lemosslucas/CoRA2025/pdfs/Cora2025CodeDocumentation_EN.pdf

# Code Documentation for the Turtle Lines Robot

# CoRA 2025 Competition - UFMG

# Lucas Lemos Ricaldoni

## September

2025

# Contents

1 Introduction | 4
2 Dependencies | 4
3 Main Code Structure: CoRA2025.ino | 4
4 Challenges File: challenges.cpp | 16

1

5 Motor Control File: motors.cpp | 27
6 Constants and Global Variables File: constants.cpp | 28

2

7 Analysis and Visualization Script: plot_log.py | 31
8 Bibliographical References | 35
9 Conclusion | 36

3

# 1 Introduction

### This document presents the documentation for the code developed for the "Turtle Lines" line-following robot, designed for the CoRA 2025 competition at UFMG. The system is based on a microcontroller and uses infrared sensors

for track detection and a gyroscope to assist with navigation.

# 2 Dependencies

### The code was developed in C++ for the Arduino platform. The following libraries are required for the project to compile and run:

- MPU6050.h: (https://github.com/jrowberg/i2cdevlib/tree/master/Arduino/MPU6050) For communication with the MPU6050 gyroscope and accelerometer.
- Wire.h: (https://www.arduino.cc/reference/en/language/functions/communication/wire/) For I2C communication with the MPU6050 sensor.
- SPI.h and SD.h: For communication with the SD card module.

# 3 Main Code Structure: CoRA2025.ino

### The CoRA2025.ino file is the heart of the system, responsible for orchestrating all the robot’s operations, from reading sensors to controlling motors

and executing the competition’s challenge logic.

## 3.1 Function setup()

This function is executed once when the robot is powered on or reset.

### Its main purpose is to initialize all the necessary hardware and software

components for operation.

### - Initializes serial communication and the SD card (if the respective de-

bug modes are active).

4

### - Configures the pins for the line sensors and the LED as inputs and

outputs.

- Initializes I2C communication (Wire) for the gyroscope.

### - Starts and calibrates the gyroscope (MPU6050) to obtain the bias

value.

- Configures the motors for motion control.
- Turns on the front LED to indicate that initialization is complete.
1 | void setup () {
2 | // Initialize serial communication
3 | if ( debugMode ) Serial . begin (9600) ;
4 | if ( debugSD ) setup_sd () ;
5 | // Sensor initialization
6 | pinMode ( sensor_esquerda , INPUT ) ;
7 | pinMode ( sensor_esquerda_central , INPUT ) ;
8 | pinMode ( sensor_central , INPUT ) ;
9 | pinMode ( sensor_direita_central , INPUT ) ;
10 | pinMode ( sensor_direita , INPUT ) ;
11 | pinMode ( sensor_curva_esquerda , INPUT ) ;
12 | pinMode ( sensor_curva_direita , INPUT ) ;
13 | pinMode ( LEDS , OUTPUT ) ;
14 | // Gyroscope initialization
15 | Wire . begin () ;
16 | mpu . begin () ;

17
18 | // turn on motors
19 | setup_motor () ;

20
21 | // Calibrate the gyroscope
22 | gyro_bias_z = calibrate_gyro () ;
23 | // turn on the face LEDs to indicate the robot has started
24 | digitalWrite ( LEDS , HIGH ) ;
25 | tempoLedLigou = millis () ;
26 | ledLigado = true ;
27 | }
Listing 1: Robot initialization function.

## 3.2 Function setup_sd()

### This function initializes the SD card and creates a new log file. To avoid

overwriting data, the function generates a unique file name at each startup,

5

using the value of the Kp constant and a sequential index (e.g., L180_0.TXT,

### L180_1.TXT). If the file is created successfully, a detailed header is written

to facilitate later data analysis.

1 | void setup_sd () {
2 | if (! SD . begin ( chipSelect ) ) {
3 | if ( debugMode ) Serial . println ("SD Card initialization
| failed !") ;
4 | return ;
5 | }

6
7 char newFileName [16];

8
9 | // Search for the first available index
10 | for (int i = 0; i < 100; i ++) {
11 | // Format the file name safely using snprintf
12 | snprintf ( newFileName , sizeof ( newFileName ) , "L%d_%d. TXT ",
| (int ) Kp , i) ;
13 | // Check if the file does NOT exist
14 | if (! SD . exists ( newFileName ) ) {
15 | break ;
16 | // Found an available name
17 | }
18 | }

19
20 | if ( debugMode ) {
21 | Serial . print (" Creating new log file : ") ;
22 | Serial . println ( newFileName ) ;
23 | }

24
25 | // Open the new file for writing
26 | logFile = SD . open ( newFileName , FILE_WRITE ) ;
27 | if ( logFile ) {
28 | logFile . println ("Time ,Error , Challenge , MarcacaoDireita ,
| MarcacaoEsquerda ,T_Dir ,T_Esq , Velocidade Direita , Velocidade
| Esquerda ,sc0 ,s0 ,s1 ,s2 ,s3 ,s4 , sc1 ") ;
29 | logFile . flush () ;
30 | if( debugMode ) Serial . println (" Log file created
| successfully .") ;
31 | } else {
32 | if( debugMode ) Serial . println (" Failed to create the log
| file .") ;
33 | }
34 | }
Listing 2: SD card initialization and log file creation.

6

## 3.3 Function write_sd()

Responsible for writing a line of data to the log file. With each call,

### the function records a complete set of telemetry data, including the time (‘millis()‘), error, a challenge marker, count and time of markings, motor speeds, and the state of all seven sensors. Using ‘logFile.flush()‘ ensures that

the data is written to the card immediately.

1 | void write_sd ( int challenge_marker = 0) {
2 | if ( logFile ) {
3 | logFile . print ( millis () ) ;
4 | logFile . print (",") ;
5 | logFile . print ( erro ) ;
6 | logFile . print (",") ;
7 | logFile . print ( challenge_marker );
8 | logFile . print (",") ;
9 | logFile . print ( marcacoesDireita );
10 | logFile . print (",") ;
11 | logFile . print ( marcacoesEsquerda ) ;
12 | logFile . print (",") ;
13 | logFile . print ( tempoMarcacaoDireita ) ;
14 | logFile . print (",") ;
15 | logFile . print ( tempoMarcacaoEsquerda ) ;
16 | logFile . print (",") ;
17 | logFile . print ( velocidadeDireita ) ;
18 | logFile . print (",") ;
19 | logFile . print ( velocidadeEsquerda ) ;
20 | for (int i = 0; i < 5; i ++) {
21 | logFile . print (",") ;
22 | logFile . print ( SENSOR [ i ]) ;
23 | }
24 | for (int i = 0; i < 2; i ++) {
25 | logFile . print (",") ;
26 | logFile . print ( SENSOR_CURVA [ i ]) ;
27 | }
28 | logFile . println () ;
29 | logFile . flush () ;

30
31 | if ( debugMode ) {
32 | if ( challenge_marker != 0) Serial . println (" Challenge
| event logged to SD.") ;
33 | }
34 | }
35 | }
Listing 3: Writes telemetry data to the SD card.

7

## 3.4 Function ler_sensores()

### Responsible for reading the digital state of the line sensors and the curve

sensors.

### - Updates the global arrays SENSOR and SENSOR_CURVA with the read

values.

- A value of PRETO (1) indicates that the sensor has detected the line, while BRANCO (0) indicates the opposite.
1 | void ler_sensores () {
2 | SENSOR [0] = digitalRead ( sensor_esquerda ) ;
3 | SENSOR [1] = digitalRead ( sensor_esquerda_central ) ;
4 | SENSOR [2] = digitalRead ( sensor_central ) ;
5 | SENSOR [3] = digitalRead ( sensor_direita_central ) ;
6 | SENSOR [4] = digitalRead ( sensor_direita ) ;
7 | SENSOR_CURVA [0] = digitalRead ( sensor_curva_esquerda ) ;
8 | SENSOR_CURVA [1] = digitalRead ( sensor_curva_direita ) ;
9 | }
Listing 4: Reading the line and curve sensors.

## 3.5 Function ajusta_movimento()

Adjusts the motor speeds based on the output value of the PID controller.

### - Calculates the speed for the right and left motors by subtracting and

adding the PID value to the base speed, respectively.

### - Uses the constrain function to ensure that the speed values remain

within the valid range (0 to 255).

- Actuates the motors with the new calculated speeds.
1 | void ajusta_movimento () {
2 | // Change the speed value
3 | velocidadeDireita = constrain ( velocidadeBaseDireita - PID ,
| 0 , 255) ;
4 | velocidadeEsquerda = constrain ( velocidadeBaseEsquerda + PID
| , 0 , 255) ;
5 | // Send the new speed to the run function

8

6 | run ( velocidadeDireita , velocidadeEsquerda ) ;
7 | }
Listing 5: Adjusting the motor speed.

## 3.6 Function calcula_erro()

Calculates the robot’s position error relative to the line.

### - The error is calculated using a weighted average of the readings from

the 5 line sensors.

### - The result indicates the distance and direction of the robot’s deviation

from the center of the line.

### - If all sensors are on the black color, the function considers that the line

has been lost.

- Before the calculation, the function calls verifica_inversao() and, if an inversion is completed, activates the faixa_de_pedestre flag.
1 | void calcula_erro () {
2 | // Update sensor values
3 | ler_sensores () ;
4 | // Check for inversion , signaling a pedestrian crossing
5 | verifica_inversao ( SENSOR , SENSOR_CURVA ) ;

6
7 | if ( inversao_finalizada ) {
8 | faixa_de_pedestre = true ;
9 | }

10
11 | // Initialize variables for error calculation
12 | int pesos [5] = { -2 , -1 , 0, 1 , 2};
13 | int somatorioErro = 0;
14 | int sensoresAtivos = 0;

15
16 | // Perform a summation with the sensor values and weights
17 | for (int i = 0; i < 5; i ++) {
18 | somatorioErro += SENSOR [ i] * pesos [ i ];
19 | sensoresAtivos += SENSOR [i ];
20 | }

21
22 | // Determine the car ’s error
23 | if ( sensoresAtivos == QUANTIDADE_TOTAL_SENSORES ) {

9

24 | erro = LINHA_NAO_DETECTADA ;
25 | } else {
26 | int sensoresInativos = QUANTIDADE_TOTAL_SENSORES -
| sensoresAtivos ;
27 | erro = somatorioErro / sensoresInativos ;
28 | }
29 | }
Listing 6: Calculation of the position error.

## 3.7 Function calcula_PID()

Implements the PID (Proportional-Integral-Derivative) controller.

- Proportional (P): Reacts proportionally to the current error.

### - Integral (I): Accumulates the error over time to correct persistent

deviations.

### - Derivative (D): Responds to the rate of change of the error to dampen

oscillations.

### - The final PID value is the weighted sum of these three components and

is used to adjust the motor speeds.

1 | void calcula_PID () {
2 | // Initialize variables for calculation
3 | PID = 0;
4 | P = erro ;
5 | I = constrain ( I + P , -255 , 255) ;
6 | D = erro - erroAnterior ;
7 | // Calculate PID
8 | PID = ( Kp * P ) + ( Ki * I ) + ( Kd * D ) + OFFSET ;
9 | // Update the previous error value
10 | erroAnterior = erro ;
11 | }
Listing 7: Calculation of the PID control.

## 3.8 Function imprime_serial()

Sends debugging information to the serial monitor.

10

- Prints the state of the curve and line sensors.
- Invokes the error and PID calculation functions and prints their results, as well as the resulting motor speeds.
1 | void imprime_serial () {
2 | // Print sensor values
3 | Serial . print ( SENSOR_CURVA [0]) ;
4 | Serial . print (" | ") ;

5
6 | for (int i = 0; i < 5; i ++) {
7 | Serial . print ( SENSOR [ i ]) ;
8 | Serial . print (" | ") ;
9 | }

10
11 | Serial . print ( SENSOR_CURVA [1]) ;
12 | Serial . print (" | ") ;

13
14 | // Print Error , PID , and speed variables
15 | Serial . print ("\ tErro : ") ;
16 | calcula_erro () ;
17 | Serial . print ( erro ) ;
18 | Serial . print (" PID : ") ;
19 | calcula_PID () ;
20 | Serial . print ( PID ) ;
21 | Serial . print (" Velocidade Direita : ") ;
22 | Serial . print ( velocidadeDireita ) ;
23 | Serial . print (" Velocidade Esquerda : ") ;
24 | Serial . println ( velocidadeEsquerda ) ;
25 | }
Listing 8: Printing debug data.

## 3.9 Main Function loop()

### This is the main loop of the program, executed continuously. The new logic is a more sophisticated state machine to handle the various competition

scenarios.

### 3.9.1 Competition Logic

### - Drag Race Mode: If arrancadaMode is true, the robot performs a

simple line following without the challenge logic.

11

### - Competition Mode:

1. Reading and Detection: In each cycle, the sensors are read, and it is checked if there is a 90-degree curve.

### 2. Pedestrian Crossing: It is detected after a track inversion. The robot waits for a confirmation (counting 3 readings of "all sensors

on black") before executing the stop maneuver.

### 3. Line Following: If no curve is detected and the line is visible, the robot follows the track normally using PID control. Line recovery

attempts are reset after some time if the robot remains stable.
4. Curve/Challenge Detection: If a 90-degree curve is detected, the robot analyzes the side markings to decide the maneuver.

### – Simple Curve: If one or more markings are seen on only one

side, it executes a 90-degree turn to that side.

### – Reverse vs. Intersection: If markings are seen on both sides, the robot measures the time difference between their detection. A significant time difference indicates a reverse maneuver. If the time is very close, it indicates a doubtful

intersection.

### 3.9.2 Exception Handling (Line Loss)

### - Tolerance: If the line is lost, a counter is started. Action is only

taken after a number of cycles (LIMITE_TOLERANCIA_LINHA_PERDIDA) to ignore momentary failures.

### - Recovery: The robot executes the tenta_recuperar_linha() func-

tion. If successful, it increments an attempt counter.

### - Stop Area: If the recovery fails, or if the number of recoveries in

a short period exceeds the limit (LIMITE_TENTATIVAS_RECUPERACAO),

### the robot stops completely in the stop area, considering the course

finished.

### 3.9.3 Debug Mode

### If the debugMode flag is active, the main logic is ignored, and the robot continuously prints sensor data to the serial monitor for calibration and anal-

ysis.

12

56 | void loop () {
57 | // check the state of the led
58 | verifica_estado_led () ;
59 | if (! debugMode ) {
60 | if ( arrancadaMode ) {
61 | ler_sensores () ;
62 | calcula_erro () ;
63 | calcula_PID () ;
64 | ajusta_movimento () ;
65 | if ( debugSD ) write_sd (0) ;
66 | } else {
67 | ler_sensores () ;
68 | int posicao = calcula_posicao ( SENSOR ) ;
69 | if ( posicao != 0) {
70 | ultima_posicao_linha = posicao ;
71 | }
72 | // check if there is a 90 - degree curve
73 | int saidaCurva = verifica_curva_90 ( SENSOR , SENSOR_CURVA
| ) ;
74 | if (! inversaoAtiva ) {
75 | if ( saidaCurva != CURVA_NAO_ENCONTRADA && ( millis () -
| tempoUltimaCurva < DEBOUNCE_TEMPO_CURVA ) ) {
76 | saidaCurva = CURVA_NAO_ENCONTRADA ;
77 | }
78 | }

79
80 | if ( faixa_de_pedestre ) {
81 | // noise filter
82 | if ( calcula_sensores_ativos ( SENSOR ) ==
| QUANTIDADE_TOTAL_SENSORES ) {
83 | qnt_fim_inversao += 1;
84 | }

85
86 | if ( qnt_fim_inversao >= 3) {
87 | if ( debugSD ) write_sd (2) ;
88 | realiza_faixa_de_pedestre () ;
89 | faixa_de_pedestre = false ;
90 | }
91 | }

92
93 | if ( saidaCurva == CURVA_NAO_ENCONTRADA ) {
94 | calcula_erro () ;
95 | if ( erro != LINHA_NAO_DETECTADA ) {
96 | // follow normally
97 | calcula_PID () ;
98 | if (( SENSOR_CURVA [0] == PRETO && SENSOR_CURVA [1] ==
| PRETO ) || inversaoAtiva ) {
99 | ajusta_movimento () ;
100 | }

13

101
102 | if ( millis () - tempoUltimaRecuperacao >
| TEMPO_RESET_TENTATIVAS ) {
103 | tentativasRecuperacao = 0;
104 | }

105
106 | if ( debugSD ) write_sd (0) ;
107 | contadorLinhaPerdida = 0;
108 | } else if ( erro == LINHA_NAO_DETECTADA ) {
109 | // lost the line
110 | if ( contadorLinhaPerdida == 0) {
111 | tempoSemLinha = millis () ;
112 | }
113 | contadorLinhaPerdida ++;
114 | if ( contadorLinhaPerdida >
| LIMITE_TOLERANCIA_LINHA_PERDIDA || millis () -
| tempoSemLinha > 1000) {

115
116 | stop_motors () ;
117 | if ( tenta_recuperar_linha () ) {
118 | contadorLinhaPerdida = 0;
119 | tentativasRecuperacao ++;
120 | tempoUltimaRecuperacao = millis () ;

121
122 | if ( tentativasRecuperacao >=
| LIMITE_TENTATIVAS_RECUPERACAO ) {
123 | erro = erroAnterior ;
124 | if ( debugSD ) write_sd (3) ;
125 | area_de_parada () ;
126 | }
127 | } else {
128 | erro = erroAnterior ;
129 | if ( debugSD ) write_sd (3) ; // Log challenge 3:
| Stop area
130 | area_de_parada () ;
131 | }
132 | }
133 | }
134 | } else if ( saidaCurva != CURVA_NAO_ENCONTRADA ) {
135 | // avoid activating at intersections
136 | if ( calcula_sensores_ativos ( SENSOR ) > 1) {
137 | if (! inversaoAtiva ) {
138 | marcacoesDireita = 0;
139 | marcacoesEsquerda = 0;

140
141 | analisa_marcacoes () ;

142
143 | if ( marcacoesDireita == 1 && marcacoesEsquerda ==
| 1 ) {

14

144 | unsigned long deltaTempo ;
145 | if ( tempoMarcacaoDireita >
| tempoMarcacaoEsquerda ) {
146 | deltaTempo = tempoMarcacaoDireita -
| tempoMarcacaoEsquerda ;
147 | } else {
148 | deltaTempo = tempoMarcacaoEsquerda -
| tempoMarcacaoDireita ;
149 | }

150
151 | if ( deltaTempo >= TOLERANCIA_TEMPO_SIMULTANEO )
| {
152 | saidaCurva = ( tempoMarcacaoDireita <
| tempoMarcacaoEsquerda ) ?
153 | CURVA_DIREITA : CURVA_ESQUERDA ;
154 | realiza_marcha_re ( saidaCurva ) ;
155 | } else {
156 | turn_90 ( CURVA_EM_DUVIDA ) ;
157 | if ( debugSD ) write_sd (6) ;
158 | }
159 | } else if ( marcacoesDireita >= 1 ||
| marcacoesEsquerda >= 1) {
160 | turn_90 ( saidaCurva );
161 | }
162 | }

163
164 | stop_motors () ;
165 | }
166 | }
167 | }
168 | } else {
169 | if ( debugMotor ) {
170 | test_motors () ;
171 | } else {
172 | // Get the output of the car ’s data
173 | ler_sensores () ;
174 | imprime_serial () ;
175 | }
176 | }

177
178 | delay (5) ;
179 | }
Listing 9: Main execution loop of the robot.

15

# 4 Challenges File: challenges.cpp

### This file contains the logic for handling the specific challenges of the competition. It has been restructured to include a more robust state machine

for detecting inversions and more refined logic for each maneuver.

## 4.1 Function verifica_estado_led()

### A simple management function that checks if the LED’s initialization

time (TEMPO_MAX_LED_LIGADO) has passed and, if so, turns off the LED.

1 | void verifica_estado_led () {
2 | if ( ledLigado ) {
3 | if ( millis () - tempoLedLigou >= TEMPO_MAX_LED_LIGADO ) {
4 | digitalWrite ( LEDS , LOW ) ;
5 | ledLigado = false ;
6 | }
7 | }
8 | }
Listing 10: Checks and turns off the status LED after the defined time.

## 4.2 Function calcula_sensores_ativos()

### This helper function counts how many of the five main line sensors are

currently on the black color.

1 | int calcula_sensores_ativos (int SENSOR []) {
2 | int sensoresAtivos = 0;
3 | for(int i = 0; i < 5; i ++) {
4 | sensoresAtivos += SENSOR [ i ];
5 | }
6 | return sensoresAtivos ;
7 | }
Listing 11: Calculates the number of active sensors.

16

## 4.3 Function verifica_curva_90()

### Analyzes the combination of sensor readings to determine if the robot has encountered a 90-degree curve. The logic identifies a curve when at least 2

central sensors are active and one of the side curve sensors is also active.

1 | int verifica_curva_90 ( int SENSOR [] , int SENSOR_CURVA []) {
2 | int sensores_pretos = calcula_sensores_ativos ( SENSOR ) ;

3
4 | if ( SENSOR_CURVA [0] == PRETO && sensores_pretos >= 2 &&
| SENSOR_CURVA [1] == BRANCO ) {
5 | return CURVA_ESQUERDA ;
6 | }
7 | if ( SENSOR_CURVA [0] == BRANCO && sensores_pretos >= 2 &&
| SENSOR_CURVA [1] == PRETO ) {
8 | return CURVA_DIREITA ;
9 | }
10 | if ( SENSOR [1] == PRETO && SENSOR [3] == PRETO &&
| SENSOR_CURVA [0] == BRANCO && SENSOR_CURVA [1] == BRANCO ) {
11 | return CURVA_EM_DUVIDA ;
12 | }

13
14 | return CURVA_NAO_ENCONTRADA ;
15 | }
Listing 12: Checks for the existence of a 90-degree curve.

## 4.4 Function calcula_posicao()

### Calculates a weighted average position of the line based on active sensors, returning a value between -2 and 2. It is used to make small angle

adjustments before a 90-degree turn.

1 | int calcula_posicao ( int SENSOR []) {
2 | int pesos [5] = { -2 , -1 , 0 , 1 , 2};
3 | int somaPesos = 0 , somaAtivos = 0;

4
5 | for (int i = 0; i < 5; i ++) {
6 | if ( SENSOR [ i ] == PRETO ) {
7 | somaPesos += pesos [ i ];
8 | somaAtivos ++;
9 | }
10 | }

11
12 | if ( somaAtivos == 0) return 0;
13 | return somaPesos / somaAtivos ;

17

14 }
Listing 13: Calculates the weighted position of the line.

## 4.5 Function turn_90()

### Executes the 90-degree turn maneuver. The function moves forward until it passes the initial marking, stops, calculates an adjusted turn angle based on the line’s position, and after rotating, moves forward again until it realigns

on the track to avoid duplicate detections.

1 | void turn_90 ( int curvaEncontrada ) {
2 | if (! inversaoAtiva ) {
3 | unsigned long startTime = millis () ;
4 | while ( calcula_sensores_ativos ( SENSOR ) <= 1) {
5 | run ( velocidadeBaseDireita , velocidadeBaseEsquerda ) ;
6 | ler_sensores () ;
7 | }
8 | delay (50) ;

9
10 | stop_motors () ;
11 | delay (100) ;
12 | int posicao = calcula_posicao ( SENSOR ) ;
13 | int ajuste = posicao * 0;
14 | int anguloFinal = 80 + ajuste ;

15
16 | stop_motors () ;
17 | delay (200) ;

18
19 | erro = erroAnterior ;
20 | if ( curvaEncontrada == CURVA_ESQUERDA ) {
21 | turn_right ( velocidadeBaseDireita ,
| velocidadeBaseEsquerda ) ;
22 | turn_until_angle ( anguloFinal ) ;
23 | } else if ( curvaEncontrada == CURVA_DIREITA ) {
24 | turn_right ( velocidadeBaseDireita ,
| velocidadeBaseEsquerda ) ;
25 | turn_until_angle ( anguloFinal ) ;
26 | }

27
28 | stop_motors () ;
29 | delay (100) ;
30 | while ( true ) {
31 | calcula_erro () ;
32 | calcula_PID () ;
33 | ajusta_movimento () ;

18

34 | if ( SENSOR_CURVA [0] == PRETO && SENSOR_CURVA [1] ==
| PRETO && SENSOR [2] == BRANCO ) {
35 | break ;
36 | }
37 | }
38 | tempoUltimaCurva = millis () ;
39 | marcacoesDireita = 0; marcacoesDireita = 0;
40 | }
41 | }
Listing 14: Executes an improved 90-degree turn.

## 4.6 Function calibrate_gyro()

### Calibrates the gyroscope by measuring its drift (bias) while the robot is stationary. The average of multiple readings is calculated and stored to

correct future measurements.

1 | float calibrate_gyro ( int samples = 200) {
2 | if ( debugMode ) Serial . println (" Calibrating gyroscope ...
| Keep the robot stationary .") ;

3
4 | float sum_gz = 0;
5 | for (int i = 0; i < samples ; i ++) {
6 | mpu . update () ;
7 | sum_gz += mpu . getGyroZ () ;
8 | delay (10) ;
9 | }

10
11 | float bias_gz = sum_gz / samples ;

12
13 | if ( debugMode ) {
14 | Serial . print (" Calibration complete . Gyroscope Bias (Gz)
| = ") ;
15 | Serial . println ( bias_gz , 4) ;
16 | }

17
18 | return bias_gz ;
19 | }
Listing 15: Calibrates the gyroscope.

19

## 4.7 Function turn_until_angle()

Performs a precise rotation of the robot until a target angle is reached, using the gyroscope.

1 | void turn_until_angle ( int target_angle = 90) {
2 | unsigned long previous_time = millis () ;
3 | float angle_z = 0;

4
5 | while ( abs ( angle_z ) < target_angle ) {
6 | mpu . update () ;
7 | float angular_velocity_z = mpu . getGyroZ () - gyro_bias_z ;

8
9 | unsigned long current_time = millis () ;
10 | float delta_time = ( current_time - previous_time ) /
| 1000.0;
11 | previous_time = current_time ;

12
13 | angle_z += angular_velocity_z * delta_time ;
14 | delay (10) ;
15 | }
16 | stop_motors () ;
17 | }
Listing 16: Rotates the robot to a specific angle.

## 4.8 Function inverte_sensor()

### Inverts the logic of a sensor (1 becomes 0, 0 becomes 1), allowing the

robot to follow a line of inverted color.

1 | int inverte_sensor ( int sensor ) {
2 | if ( sensor == 1) {
3 | return 0;
4 | }
5 | return 1;
6 | }
Listing 17: Inverts the value of a sensor.

## 4.9 Function verifica_inversao()

### Implements a state machine to detect and manage crossing a section of

the track with inverted colors.

20

### - Entry: Activates the inversion mode (inversaoAtiva) when only 1

line sensor is active.

### - During Inversion: Inverts the reading of all sensors so that the line

follower logic continues to work.

### - Exit: Deactivates the inversion mode when the curve and line sensors indicate the end of the section. Upon exiting, it activates the

inversao_finalizada flag to signal a possible pedestrian crossing.

1 | bool verifica_inversao ( int SENSOR [] , int SENSOR_CURVA []) {
2 | int ativos = calcula_sensores_ativos ( SENSOR ) ;

3
4 | if ( ativos == 1 && ! inversaoAtiva && SENSOR_CURVA [0] ==
| BRANCO && SENSOR_CURVA [1] == BRANCO ) {
5 | inversaoAtiva = true ;
6 | tempoInversaoAtivada = millis () ;
7 | }

8
9 | if ( inversaoAtiva && millis () - tempoInversaoAtivada >
| 1000) {
10 | if ( ativos >= 3 && SENSOR_CURVA [0] == PRETO &&
| SENSOR_CURVA [1] == PRETO ) {
11 | inversaoAtiva = false ;
12 | inversao_finalizada = true ;
13 | return false ;
14 | }
15 | }

16
17 | if ( inversaoAtiva ) {
18 | for (int i = 0; i < 5; i ++) {
19 | SENSOR [ i ] = inverte_sensor ( SENSOR [ i ]) ;
20 | }
21 | return true ;
22 | }
23 | return false ;
24 | }
Listing 18: Checks and handles the track color inversion.

## 4.10 Function realiza_faixa_de_pedestre()

### Executes a robust routine for the pedestrian crossing. The robot stops

for the defined time, reverses slightly to find the line again, realigns on it, and then moves forward at high speed to ensure a complete crossing.

21

1 | void realiza_faixa_de_pedestre () {
2 | stop_motors () ;
3 | delay ( TIMEOUT_FAIXA_PEDESTRE ) ;

4
5 | unsigned long start = millis () ;
6 | while ( erro == LINHA_NAO_DETECTADA || millis () - start <
700) {
7 | ler_sensores () ;
8 | calcula_erro () ;
9 | run_backward (150 , 150) ;
10 | }
11 | stop_motors () ;

12
13 | int pos = calcula_posicao ( SENSOR ) ;
14 | if ( pos < -1) {
15 | run ( - velocidadeBaseDireita , velocidadeBaseEsquerda ) ;
16 | } else if ( pos > 1) {
17 | run ( velocidadeBaseDireita , - velocidadeBaseEsquerda ) ;
18 | }
19 | while ( SENSOR [1] != PRETO && SENSOR [2] != BRANCO && SENSOR
[3] != PRETO ) {
20 | ler_sensores () ;
21 | }
22 | stop_motors () ;
23 | delay (500) ;

24
25 | run (255 , 255) ;
26 | delay ( TIMEOUT_PERIODO_FAIXA ) ;

27
28 // ... ( Crossing finalization logic )

29
30 | inversao_finalizada = false ;
31 | }
Listing 19: Executes the pedestrian crossing challenge with realignment.

## 4.11 Function realiza_marcha_re()

### Executes the reverse gear challenge. The robot stops, moves backward at high speed, stops again, moves forward a little to position itself, and then

performs the 90-degree turn to the determined side.

1 | void realiza_marcha_re ( int lado_da_curva ) {
2 | if ( debugSD ) write_sd (7) ;
3 | stop_motors () ;
4 | delay (1000) ;

22

5
6 | run_backward (255 , 255) ;
7 | delay (1200) ;

8
9 | stop_motors () ;
10 | delay (500) ;

11
12 | run ( velocidadeBaseDireita , velocidadeBaseEsquerda ) ;
13 | delay (200) ;

14
15 turn_90 ( lado_da_curva ) ;

16
17 | stop_motors () ;
18 | delay (500) ;
19 | }
Listing 20: Executes the reverse gear challenge.

## 4.12 Function realiza_rotatoria()

### Controls navigation in the roundabout. After entering, the robot follows the line and uses logic with a flag (aguardando_realinhar) and a detection counter to reliably count the exits, preventing the same exit from being counted multiple times. Upon reaching the desired exit, it executes the

maneuver to leave the roundabout.

1 | void realiza_rotatoria ( int saidaCurva , int saidaDesejada ) {
2 | bool aguardando_realinhar = false ;
3 | static int contador_deteccao_saida = 0;
4 | const int TOLERANCIA_SAIDA = 2;
5 | int saidaAtual = 0;

6
7 | if ( saidaCurva == SAIDA_ESQUERDA ) {
8 | turn_left ( velocidadeBaseDireita , velocidadeBaseEsquerda ) ;
9 | turn_until_angle (90) ;
10 | } else if ( saidaCurva == SAIDA_DIREITA ) {
11 | turn_right ( velocidadeBaseDireita , velocidadeBaseEsquerda )
| ;
12 | turn_until_angle (90) ;
13 | }

14
15 | while ( saidaAtual < saidaDesejada ) {
16 | calcula_erro () ;
17 | ajusta_movimento () ;

18

23

19 | bool saida_detectada = ( SENSOR_CURVA [0] == PRETO &&
| SENSOR_CURVA [1] == BRANCO ) ;
20 | bool robo_realinhado = ( SENSOR_CURVA [0] == PRETO &&
| SENSOR_CURVA [1] == PRETO ) ;

21
22 | if (! aguardando_realinhar ) {
23 | if ( saida_detectada ) {
24 | contador_deteccao_saida ++;
25 | } else {
26 | contador_deteccao_saida = 0;
27 | }
28 | if ( contador_deteccao_saida >= TOLERANCIA_SAIDA ) {
29 | saidaAtual ++;
30 | aguardando_realinhar = true ;
31 | contador_deteccao_saida = 0;
32 | }
33 | } else {
34 | if ( robo_realinhado ) {
35 | aguardando_realinhar = false ;
36 | }
37 | }
38 | }

39
40 | if ( saidaCurva == SAIDA_ESQUERDA ) {
41 | turn_right ( velocidadeBaseDireita ,
| velocidadeBaseEsquerda ) ;
42 | turn_until_angle (90) ;
43 | } else {
44 | turn_left ( velocidadeBaseDireita , velocidadeBaseEsquerda
| ) ;
45 | turn_until_angle (90) ;
46 | }
47 | }
Listing 21: Executes the roundabout challenge with improved exit counting.

## 4.13 Function tenta_recuperar_linha()

### Recovery routine executed when the line is lost. The robot moves backward for a time limit (TIME_WITHOUT_LINE), searching for the line. To con-

firm that the line has been found, it requires 3 consecutive valid readings.

1 | bool tenta_recuperar_linha () {
2 | unsigned long tempoPerdido = millis () ;
3 | int leiturasValidas = 0;

4

24

5 | while ( millis () - tempoPerdido < TIME_WITHOUT_LINE ) {
6 | run_backward ( velocidadeBaseDireita ,
| velocidadeBaseEsquerda ) ;
7 | delay (50) ;
8 | ler_sensores () ;

9
10 | if ( SENSOR [1] == PRETO || SENSOR [2] == PRETO || SENSOR [3]
| == PRETO ) {
11 | leiturasValidas ++;
12 | if ( leiturasValidas >= 3) {
13 | stop_motors () ;
14 | return true ;
15 | }
16 | } else {
17 | leiturasValidas = 0;
18 | }
19 | }
20 | return false ;
21 | }
Listing 22: Attempts to recover the line by moving backward.

## 4.14 Function conta_marcacao()

### Performs the counting of markers (black squares). The logic has been improved to count on the transition to white and require a minimum number of readings (TOLERANCIA_MARCACAO) to avoid noise, ensuring each marker is

counted only once.

1 | int conta_marcacao ( int estadoSensor , int contagemAtual , bool
| & jaContou , int & contadorBranco , unsigned long &
| tempoMarcacao ) {
2 | if ( calcula_sensores_ativos ( SENSOR ) <= 1) return
| contagemAtual ;
3 | if ( marcacoesDireita >= 1 && marcacoesEsquerda >= 1) return
| contagemAtual ;

4
5 | if ( estadoSensor == BRANCO ) {
6 | contadorBranco ++;
7 | if ( contadorBranco >= TOLERANCIA_MARCACAO && ! jaContou ) {
8 | jaContou = true ;
9 | tempoMarcacao = millis () ;
10 | return contagemAtual + 1;
11 | }
12 | } else {
13 | contadorBranco = 0;

25

14 | jaContou = false ;
15 | }
16 | return contagemAtual ;
17 | }
Listing 23: Track marker counting with a noise filter.

## 4.15 Function analisa_marcacoes()

### Orchestrates the detection of challenges. It enters a loop for a defined time (TIMEOUT_MARCACAO) after detecting a curve, calling conta_marcacao

to register the markers on each side and their respective detection times.

1 | void analisa_marcacoes () {
2 | if (! inversaoAtiva ) {
3 | unsigned long tempoUltimaDeteccao = millis () ;
4 | jaContouEsquerda = false ;
5 | jaContouDireita = false ;

6
7 | while (( millis () - tempoUltimaDeteccao < TIMEOUT_MARCACAO )
) {
8 | ler_sensores () ;

9
10 | static int contadorBrancoEsq = 0;
11 | static int contadorBrancoDir = 0;

12
13 | int marcacoesAntesEsq = marcacoesEsquerda ;
14 | int marcacoesAntesDir = marcacoesDireita ;

15
16 | marcacoesEsquerda = conta_marcacao ( SENSOR_CURVA [0] ,
marcacoesEsquerda , jaContouEsquerda , contadorBrancoEsq , tempoMarcacaoEsquerda ) ;
17 | marcacoesDireita | = conta_marcacao ( SENSOR_CURVA [1] ,
marcacoesDireita , jaContouDireita , contadorBrancoDir , tempoMarcacaoDireita ) ;

18
19 | if ( marcacoesEsquerda > marcacoesAntesEsq ||
marcacoesDireita > marcacoesAntesDir ) {
20 | tempoUltimaDeteccao = millis () ;
21 | }

22
23 | if ( marcacoesDireita >= 1 && marcacoesEsquerda >= 1) {
24 | marcacoesDireita = 1;
25 | marcacoesEsquerda = 1;
26 | }
27 | calcula_erro () ;

26

28 | calcula_PID () ;
29 | ajusta_movimento () ;
30 | }
31 | }
32 | }
Listing 24: Analyzes and counts track markers for a set duration.

## 4.16 Function area_de_parada()

### Final function that is called when the robot cannot recover from a line

loss or reaches the attempt limit. It moves forward a little, stops the motors, turns on the LED, and enters an infinite loop, finishing the course.

1 | void area_de_parada () {
2 | run ( velocidadeBaseDireita - 5 , velocidadeBaseEsquerda ) ;
3 | delay (1000) ;
4 | stop_motors () ;
5 | digitalWrite ( LEDS , HIGH ) ;
6 | tempoLedLigou = millis () ;
7 | ledLigado = true ;
8 | if ( debugSD ) write_sd (3) ; // Log challenge 3: Stop area
9 | while ( true ) ;
10 | }
Listing 25: Finishes the course in the stop area.

# 5 Motor Control File: motors.cpp

### This file represents the hardware abstraction layer for controlling the robot’s motors. It is responsible for initializing the microcontroller’s pins and providing a simple interface to perform basic movements like moving

forward, backward, turning, and stopping.

## 5.1 Function setup_motor()

Initializes the motor control pins as outputs.

1 | void setup_motor () {
2 | pinMode ( MOTOR_LEFT_CLKWISE , OUTPUT );

27

3 | pinMode ( MOTOR_LEFT_ANTI , OUTPUT ) ;
4 | pinMode ( MOTOR_RIGHT_CLKWISE , OUTPUT ) ;
5 | pinMode ( MOTOR_RIGHT_ANTI , OUTPUT ) ;
6 | stop_motors () ;
7 | }
Listing 26: Initial configuration of the motor pins.

## 5.2 Function set_state_motor()

### Low-level function that directly applies PWM values (0-255) to the motor

control pins.

1 | void set_state_motor ( int leftCw , int leftCcw , int rightCw ,
| int rightCcw ) {
2 | analogWrite ( MOTOR_LEFT_CLKWISE , leftCw ) ;
3 | analogWrite ( MOTOR_LEFT_ANTI , leftCcw ) ;
4 | analogWrite ( MOTOR_RIGHT_CLKWISE , rightCw ) ;
5 | analogWrite ( MOTOR_RIGHT_ANTI , rightCcw ) ;
6 | }
Listing 27: Sets the state and speed of each motor.

# 6 Constants and Global Variables File: constants.cpp

### This file centralizes all constants and global variables. This approach facilitates parameter adjustment and robot state management without altering

the main logic.

## 6.1 Pins and Hardware

### Defines the physical connections for the sensors, LEDs, and the Chip

Select pin for the SD card.

28

## 6.2 Sensor State Variables

### Arrays that store the readings of the line sensors (SENSOR) and curve

sensors (SENSOR_CURVA).

## 6.3 Speed and Motor Settings

### - velocidadeBase: The default speed, which is higher (255) in drag race

mode and lower (210) in competition mode.

### - OFFSET_MOTORS: An adjustment value to compensate for mechanical

differences between the motors, ensuring straight movement.

- velocidadeDireita, velocidadeEsquerda: Variables that store the speed adjusted by the PID.

## 6.4 PID Control

### - Gains: Kp, Ki, Kd. Notably, in drag race mode (arrancadaMode), the Ki and Kd gains are zeroed, turning the control into a purely Propor-

tional system, which is simpler and more aggressive.

### - Calculation Variables: erro, P, I, D, PID, etc., used for real-time

calculation.

## 6.5 Challenge State Variables

Flags and counters that manage the robot’s state during the competition.

### - inversaoAtiva: Flag that indicates if the robot is on an inverted track

section.

### - inversao_finalizada: Flag activated when exiting an inversion, sig-

naling a possible pedestrian crossing.

- marcacoesDireita, marcacoesEsquerda: Counters for the challenge markers.

29

- tempoMarcacaoDireita, tempoMarcacaoEsquerda: Store the millis() at the moment of a marker’s detection, used to differentiate challenges.

### - ultima_posicao_linha: Stores the last valid position of the line to

aid in recovery.

## 6.6 Debug Control

Boolean flags to activate different test modes.

- debugMode: Activates printing data to the serial monitor.
- debugMotor: Activates a motor test in the loop().
- debugSD: Enables logging to the SD card.

### - arrancadaMode: Activates a simplified performance mode, with higher

speed and only Proportional control.

## 6.7 Tolerance and Time Parameters

Constants that define the robot’s temporal behavior.

- TIMEOUT_FAIXA_PEDESTRE: Stop time at the pedestrian crossing.

### - TIMEOUT_MARCACAO: Duration of the time window to analyze the mark-

ers of a challenge.

### - DEBOUNCE_TEMPO_CURVA: Waiting time to avoid double detection of the

same curve.

### - TOLERANCIA_TEMPO_SIMULTANEO: Time threshold to differentiate a re-

verse gear from an intersection.

- LIMITE_TOLERANCIA_LINHA_PERDIDA: Number of "line lost" cycles before initiating recovery.

30

# 7 Analysis and Visualization Script: plot_log.py

To assist in the PID controller calibration process, a Python script, plot_log.py,

was developed. This tool allows for the analysis of the .TXT log files generated by the robot, visualization of performance in detailed graphs, and most importantly, simulation of the robot’s behavior with different PID constants without the need for a new physical run. The script recalculates the PID

output based on the error history and the new gains provided by the user, also offering automatic suggestions for optimization.

## 7.1 Function calculate_pid_values()

### This is the central function of the simulation. It iterates over each error

record from the log file and recalculates, line by line, what the Proportional,

### Integral, and Derivative terms and the final PID output would have been if the new Kp, Ki, and Kd constants had been used. The logic, including the constraint on the integral term, exactly mirrors the microcontroller’s

behavior.

1 | def calculate_pid_values ( df , Kp , Ki , Kd ) :
2 | pid_values = []
3 | I = 0
4 | erroAnterior = 0
5 | OFFSET = 0

6
7 | for erro in df [’Error ’]:
8 | P = erro
9 | I = I + P
10 | # Constrain the integral term , similar to the Arduino
| code
11 | I = max ( -255 , min (255 , I ) )
12 | D = erro - erroAnterior

13
14 | p_term_val = Kp * P
15 | i_term_val = Ki * I
16 | d_term_val = Kd * D

17
18 | PID = p_term_val + i_term_val + d_term_val + OFFSET
19 | pid_values . append ( PID )

20
21 | erroAnterior = erro

22

31

23 | return pd . DataFrame ({ ’PID ’: pid_values })
Listing 28: Recalculates the PID output with new constants.

## 7.2 Function plot_data()

### This function is responsible for generating the graphical visualization of the data. It creates a window with four superimposed plots:

### - Error vs. Time: Shows the robot’s deviation from the line, including markers for the competition challenges. A smoothed error curve (using

a Savitzky-Golay filter) is overlaid to show the overall trend of the run.

### - Smoothed Error vs. Time: Presents the smoothed error curve for

a clearer view of the trajectory.

### - PID Output vs. Time: Displays the correction value calculated by

the PID.

### - Motor Speeds vs. Time: Shows how the PID output was translated

into the speed of each motor.

1 | def plot_data ( df , Kp , Ki , Kd ) :
2 | fig , ( ax1 , ax2 , ax3 , ax4 ) = plt . subplots (4 , 1 , figsize
| =(14 , 12) , sharex = True )
3 | fig . suptitle ( f" Analysis of PID Control with Kp ={ Kp} , Ki ={
| Ki} , Kd ={ Kd}", fontsize =16)

4
5 | try :
6 | window_length = min (51 , len ( df [’Error ’]) )
7 | if window_length % 2 == 0:
8 | window_length -= 1

9
10 | if window_length > 3:
11 | df [’ Smoothed_Error ’] = savgol_filter ( df [’Error ’
| ] , window_length , 3)
12 | else :
13 | df [’ Smoothed_Error ’] = df [’Error ’]
14 | except Exception :
15 | df [’ Smoothed_Error ’] = df [’Error ’]

16
17 | ax1 . plot ( df [’Time ’] , df [’Error ’] , | marker =’o’, label =’
Error ( Actual Path )’, color =’blue ’, alpha =0.4)

32

18 | ax1 . plot ( df [’Time ’] , df [’ Smoothed_Error ’] , label =’
| Smoothed Trend ’, color =’green ’, linewidth =2.5)
19 | ax1 . axhline (0 , color =’k’, linestyle =’--’, linewidth =1 ,
| label =’Ideal Path ( Error =0) ’)

20
21 | if ’Challenge ’ in df . columns and not df [ df [’Challenge ’]
| != 0]. empty :
22 | challenges = df [ df [’Challenge ’] != 0]
23 | plotted_labels = set ()

24
25 | for _ , row in challenges . iterrows () :
26 | challenge_code = int ( row [’Challenge ’])
27 | if challenge_code in challenge_map :
28 | props = challenge_map [ challenge_code ]
29 | label = props [’label ’]

30
31 | current_label = label if label not in
| plotted_labels else ""

32
33 | ax1 . scatter ( row [’Time ’] , row [’Error ’] ,
34 | label = current_label ,
35 | color = props [’color ’] ,
36 | marker = props [’marker ’] ,
37 | s = props [’size ’] ,
38 | zorder =5)
39 | plotted_labels . add ( label )

40
41 | ax1 . set_title (’Error vs Time ’)
42 | ax1 . legend ( loc =’center left ’, bbox_to_anchor =(1 , 0.5) )

43
44 | ax2 . plot ( df [’Time ’] , df [’ Smoothed_Error ’] , label =’
| Smoothed_Error ’, color =’green ’, linewidth =2.5)
45 | ax2 . set_title (’ Smoothed_Error vs Time ’)

46
47 | ax3 . plot ( df [’Time ’] , df [’PID ’] , label =’Total PID Output ’,
| color =’red ’)
48 | ax3 . set_title (’PID Output vs Time ’)

49
50 | ax4 . plot ( df [’Time ’] , df [’ Velocidade Direita ’] , label =’
| Velocidade Direita ’, color =’purple ’)
51 | ax4 . plot ( df [’Time ’] , df [’ Velocidade Esquerda ’] , label =’
| Velocidade Esquerda ’, color =’orange ’)
52 | ax4 . set_title (’Motor Speeds vs. Time ’)

53
54 | plt . tight_layout ( rect =[0 , 0.03 , 0.85 , 0.95])
55 | plt . show ()
Listing 29: Generates the performance analysis graphs.

33

## 7.3 Function analyze_performance_and_suggest_pid()

After visualizing the graphs, this function performs a quantitative analysis of the robot’s performance. It calculates metrics such as mean absolute error (MAE), maximum error (overshoot), and the number of oscillations (using peak detection). Based on these metrics, it prints a diagnosis of the robot’s behavior in the terminal and suggests clear actions for adjusting the PID

gains, automating the calibration process.

1 | def analyze_performance_and_suggest_pid ( df , Kp , Ki , Kd ) :
2 | print ("\n- - - Performance Analysis & Adjustment
Suggestions ---")

3
4 | error = df [’Error ’]. to_numpy ()
5 | mae = np . mean ( np .abs ( error ) )
6 | max_abs_error = np . max ( np . abs ( error ) )

7
8 | peaks , _ = find_peaks ( error , prominence =0.5)
9 | troughs , _ = find_peaks (- error , prominence =0.5)
10 | num_oscillations = len ( peaks ) + len ( troughs )

11
12 | print ( f" Mean Absolute Error ( MAE ): { mae :.4 f}")
13 | print ( f" Maximum Absolute Error ( Overshoot / Undershoot ): {
max_abs_error :.4 f}")
14 | print ( f" Detected { num_oscillations } significant
oscillations .")

15
16 | print ("\ nSuggestions :")
17 | suggestion_made = False

18
19 | if num_oscillations > 8:
20 | print ("- Behavior Detected : The robot oscillates too
much ... ")
21 | print ( f" | - Recommended Action : Decrease the value of
Kp ( current : {Kp }).")
22 | suggestion_made = True

23
24 | # ... ( logic for other suggestions ) ...

25
26 | if not suggestion_made :
27 | print ("- Performance seems reasonable .")
Listing 30: Analyzes metrics and suggests adjustments for the PID.

34

## 7.4 Example of Graphical Output

### Figure 1 illustrates the analysis window generated by the plot_log.py script. It is possible to observe the error behavior (top graph), the PID controller output (middle graph), and the resulting motor speeds (bottom graph). The colored markers on the first graph indicate the exact moments

when competition events occurred, such as the detection of an ‘invertedline‘(bluesquare), the‘P edestrianCrossing‘maneuver(orangesquare), andthe‘StopArea‘(orangedot).

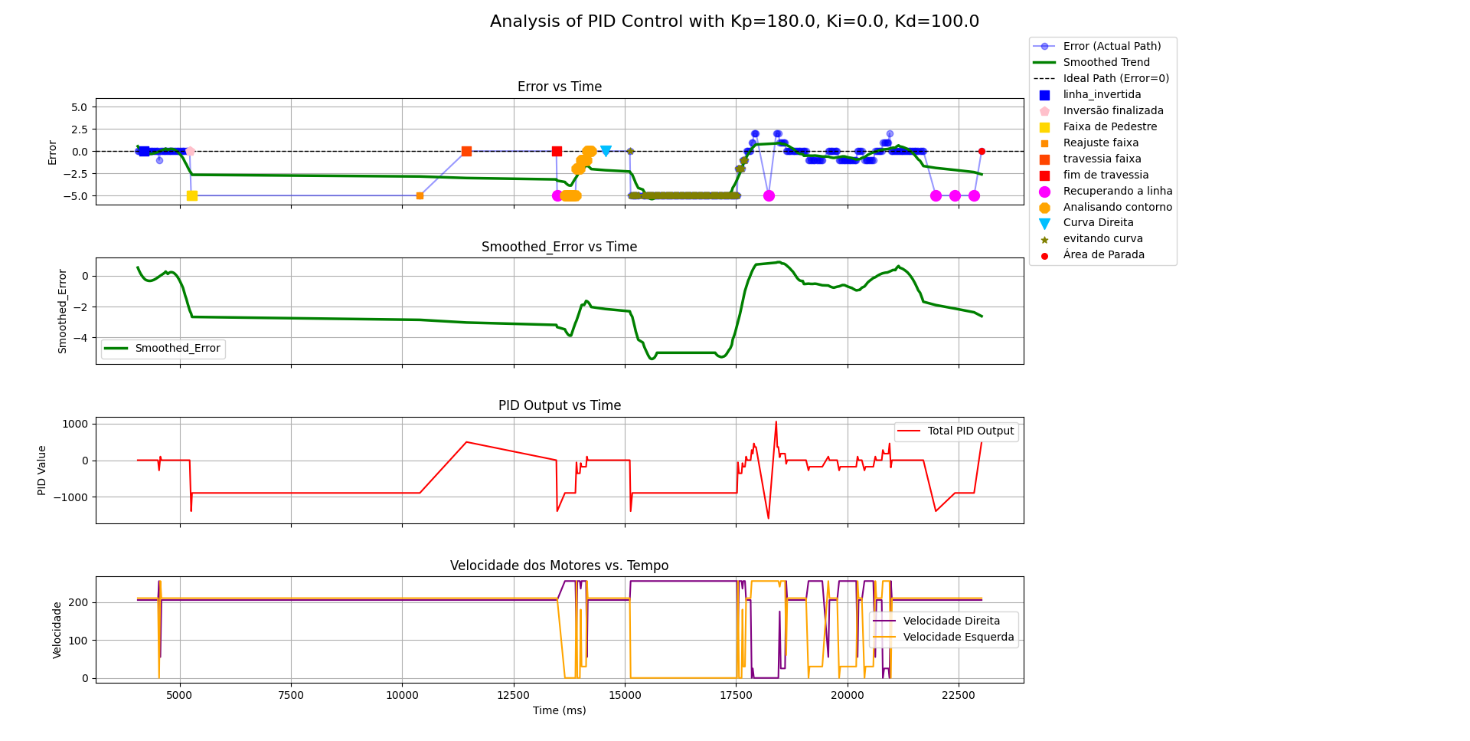
[picture p4: figure]

### Figure 1: Example of the analysis window generated by the plot_log.py

script.

# 8 Bibliographical References

## 8.1 PID Control

PID (Proportional Integral Derivative) Control is used for process control. Its objective is, through mathematical equations involving integrals and derivatives, to minimize the system’s error. The proportional control adjusts the control variable proportionally to the error. The integral control adjusts the control variable based on the time the error occurs. The derivative

control adjusts the control variable based on the rate of change of the error.

35

### PID control equation:

### P ID(t) = Kpe(t) + Ki

Z t

0

### e(τ ) dτ + Kd

d
dte(t) | (1)

### In this equation, we have the following parameters:

- Kp: proportional gain;
- Ki

: integral gain;

- Kd: derivative gain;

### - e: instantaneous error (difference between the desired value and the

measured value);

- τ : integration variable;
- t: current time.

### Below is a table explaining how to adjust the PID parameters according

to the error the robot exhibits.

Robot Behavior | Parameter to Ad-just | Recommended Action
Oscillates a lot around the line (zig-zag) | Proportional (Kp) | Decrease the value of Kp. A very high Kp causes exaggerated reactions.
Corrects slowly and cannot follow the line well | Proportional (Kp) | Increase the value of Kp. A very low Kp generates weak corrections.
A small error persists for a long time | Integral (Ki) | Increase Ki to correct slowly accumu-lating errors.
Starts oscillating after following well for a while | Integral (Ki) | Decrease Ki. A high Ki can accumulate too much error and cause instability.
Very abrupt reaction to rapid changes in the line | Derivative (Kd) | Increase Kd to smooth the response. It helps to "brake" sudden changes.
Slow response to rapid changes | Derivative (Kd) | Decrease Kd if the robot takes too long to react to curves or deviations.

### Table 1: Adjusting PID parameters based on the robot’s behavior

# 9 Conclusion

This document presents the structure and functionalities of the code,

### facilitating the understanding of the system and promoting its democratization. It provides freedom and autonomy for conducting tests and using the

36

### code in different contexts, allowing for greater flexibility in the development

and improvement of the project.

37
