lemosslucas/CoRA2025/pdfs/DocumentaçãoCodigoCoRA2025_PT.pdf

# Documentação do Código do Robô Tartaruga Linhas

# Competição CoRA 2025 - UFMG

# Lucas Lemos Ricaldoni

## Setembro

2025

# Sumário

1 Introdução | 4
2 Dependências | 4
3 Estrutura do Código Principal: CoRA2025.ino | 4
4 Arquivo de Desafios: challenges.cpp | 16

1

5 Arquivo de Controle dos Motores: motors.cpp | 28
6 Arquivo de Constantes e Variáveis Globais: constants.cpp | 29

2

7 Script de Análise e Visualização: plot_log.py | 31
8 Referências Bibliográficas | 36
9 Conclusão | 37

3

# 1 Introdução

### Este documento apresenta a documentação do código desenvolvido para o robô seguidor de linha "Tartaruga Linhas", projetado para a competição CoRA 2025 da UFMG. O sistema é baseado em um microcontrolador e utiliza sensores infravermelhos para a detecção da pista e um giroscópio para auxiliar

na navegação.

# 2 Dependências

### O código foi desenvolvido em C++ para a plataforma Arduino. As seguintes bibliotecas são necessárias para a compilação e funcionamento do projeto:

- MPU6050.h: (https://github.com/jrowberg/i2cdevlib/tree/master/Arduino/MPU6050) Para comunicação com o giroscópio e acelerômetro MPU6050.
- Wire.h: (https://www.arduino.cc/reference/en/language/functions/communication/wire/) Para comunicação I2C com o sensor MPU6050.
- SPI.h e SD.h: Para comunicação com o módulo de cartão SD.

# 3 Estrutura do Código Principal: CoRA2025.ino

### O arquivo CoRA2025.ino é o coração do sistema, responsável por orquestrar todas as operações do robô, desde a leitura dos sensores até o controle

dos motores e a execução das lógicas de desafios da competição.

## 3.1 Função setup()

### Esta função é executada uma única vez quando o robô é ligado ou resetado. Sua principal finalidade é inicializar todos os componentes de hardware

e software necessários para o funcionamento.

### - Inicializa a comunicação serial e com o cartão SD (se os respectivos

modos de depuração estiverem ativos).

4

### - Configura os pinos dos sensores de linha e do LED como entradas e

saídas.

- Inicializa a comunicação I2C (Wire) para o giroscópio.
- Inicia e calibra o giroscópio (MPU6050) para obter o valor de bias.
- Configura os motores para o controle de movimento.
- Acende o LED frontal para indicar que a inicialização foi concluída.
1 | void setup () {
2 | // Initialize serial communication
3 | if ( debugMode ) Serial . begin (9600) ;
4 | if ( debugSD ) setup_sd () ;
5 | // Sensor initialization
6 | pinMode ( sensor_esquerda , INPUT ) ;
7 | pinMode ( sensor_esquerda_central , INPUT ) ;
8 | pinMode ( sensor_central , INPUT ) ;
9 | pinMode ( sensor_direita_central , INPUT ) ;
10 | pinMode ( sensor_direita , INPUT ) ;
11 | pinMode ( sensor_curva_esquerda , INPUT ) ;
12 | pinMode ( sensor_curva_direita , INPUT ) ;
13 | pinMode ( LEDS , OUTPUT ) ;
14 | // Gyroscope initialization
15 | Wire . begin () ;
16 | mpu . begin () ;

17
18 | // liga os motores
19 | setup_motor () ;

20
21 | // Calibrate the gyroscope
22 | gyro_bias_z = calibrate_gyro () ;
23 | // liga os leds da cara para indicar que o robo iniciou
24 | digitalWrite ( LEDS , HIGH ) ;
25 | tempoLedLigou = millis () ;
26 | ledLigado = true ;
27 | }
Listing 1: Função de inicialização do robô.

## 3.2 Função setup_sd()

### Esta função inicializa o cartão SD e cria um novo arquivo de log. Para evitar a sobrescrita de dados, a função gera um nome de arquivo único a

5

### cada inicialização, usando o valor da constante Kp e um índice sequencial (ex: L180_0.TXT, L180_1.TXT). Se o arquivo for criado com sucesso, um

cabeçalho detalhado é escrito para facilitar a análise posterior dos dados.

1 | void setup_sd () {
2 | if (! SD . begin ( chipSelect ) ) {
3 | if ( debugMode ) Serial . println ("SD Card initialization
| failed !") ;
4 | return ;
5 | }

6
7 char newFileName [16];

8
9 | // Procura o primeiro indice disponivel
10 | for ( int i = 0; i < 100; i ++) {
11 | // Formata o nome do arquivo de forma segura usando
| snprintf
12 | snprintf ( newFileName , sizeof ( newFileName ) , "L%d_%d. TXT ",
| (int ) Kp , i) ;
13 | // Verifica se o arquivo Nao existe
14 | if (! SD . exists ( newFileName ) ) {
15 | break ;
16 | // Encontrou um nome disponivel
17 | }
18 | }

19
20 | if ( debugMode ) {
21 | Serial . print (" Creating new log file : ") ;
22 | Serial . println ( newFileName ) ;
23 | }

24
25 | // Abre o novo arquivo para escrita
26 | logFile = SD . open ( newFileName , FILE_WRITE );
27 | if ( logFile ) {
28 | logFile . println ("Time ,Error , Challenge , MarcacaoDireita ,
| MarcacaoEsquerda ,T_Dir ,T_Esq , Velocidade Direita , Velocidade
| Esquerda ,sc0 ,s0 ,s1 ,s2 ,s3 ,s4 , sc1 ") ;
29 | logFile . flush () ;
30 | if( debugMode ) Serial . println (" Log file created
| successfully .") ;
31 | } else {
32 | if( debugMode ) Serial . println (" Failed to create the log
| file .") ;
33 | }
34 | }
Listing 2: Inicialização do cartão SD e criação do arquivo de log.

6

## 3.3 Função write_sd()

### Responsável por escrever uma linha de dados no arquivo de log. A cada

chamada, a função registra um conjunto completo de dados de telemetria,

### incluindo o tempo (‘millis()‘), o erro, um marcador de desafio, contagem e tempo das marcações, velocidades dos motores e o estado de todos os sete sensores. O uso de ‘logFile.flush()‘ garante que os dados sejam gravados

imediatamente no cartão.

1 | void write_sd ( int challenge_marker = 0) {
2 | if ( logFile ) {
3 | logFile . print ( millis () ) ;
4 | logFile . print (",") ;
5 | logFile . print ( erro ) ;
6 | logFile . print (",") ;
7 | logFile . print ( challenge_marker ) ;
8 | logFile . print (",") ;
9 | logFile . print ( marcacoesDireita ) ;
10 | logFile . print (",") ;
11 | logFile . print ( marcacoesEsquerda ) ;
12 | logFile . print (",") ;
13 | logFile . print ( tempoMarcacaoDireita ) ;
14 | logFile . print (",") ;
15 | logFile . print ( tempoMarcacaoEsquerda ) ;
16 | logFile . print (",") ;
17 | logFile . print ( velocidadeDireita ) ;
18 | logFile . print (",") ;
19 | logFile . print ( velocidadeEsquerda ) ;
20 | for ( int i = 0; i < 5; i ++) {
21 | logFile . print (",") ;
22 | logFile . print ( SENSOR [ i ]) ;
23 | }
24 | for ( int i = 0; i < 2; i ++) {
25 | logFile . print (",") ;
26 | logFile . print ( SENSOR_CURVA [ i ]) ;
27 | }
28 | logFile . println () ;
29 | logFile . flush () ;

30
31 | if ( debugMode ) {
32 | if ( challenge_marker != 0) Serial . println (" Challenge
| event logged to SD.") ;
33 | }
34 | }
35 | }
Listing 3: Escreve dados de telemetria no cartão SD.

7

## 3.4 Função ler_sensores()

### Responsável por ler o estado digital dos sensores de linha e dos sensores

de curva.

- Atualiza os arrays globais SENSOR e SENSOR_CURVA com os valores lidos.

### - Um valor PRETO (1) indica que o sensor detectou a linha, enquanto

BRANCO (0) indica o contrário.

1 | void ler_sensores () {
2 | SENSOR [0] = digitalRead ( sensor_esquerda );
3 | SENSOR [1] = digitalRead ( sensor_esquerda_central ) ;
4 | SENSOR [2] = digitalRead ( sensor_central );
5 | SENSOR [3] = digitalRead ( sensor_direita_central ) ;
6 | SENSOR [4] = digitalRead ( sensor_direita );
7 | SENSOR_CURVA [0] = digitalRead ( sensor_curva_esquerda ) ;
8 | SENSOR_CURVA [1] = digitalRead ( sensor_curva_direita ) ;
9 | }
Listing 4: Leitura dos sensores de linha e curva.

## 3.5 Função ajusta_movimento()

### Ajusta a velocidade dos motores com base no valor de saída do controlador

PID.

### - Calcula a velocidade para o motor direito e esquerdo, subtraindo e

somando o valor do PID à velocidade base, respectivamente.

### - Utiliza a função constrain para garantir que os valores de velocidade

permaneçam dentro do intervalo válido (0 a 255).

- Aciona os motores com as novas velocidades calculadas.
1 | void ajusta_movimento () {
2 | // Change the speed value
3 | velocidadeDireita = constrain ( velocidadeBaseDireita - PID ,
| 0 , 255) ;
4 | velocidadeEsquerda = constrain ( velocidadeBaseEsquerda + PID
| , 0 , 255) ;
5 | // Send the new speed to the run function

8

6 | run ( velocidadeDireita , velocidadeEsquerda ) ;
7 | }
Listing 5: Ajuste da velocidade dos motores.

## 3.6 Função calcula_erro()

Calcula o erro de posição do robô em relação à linha.

### - O erro é calculado utilizando uma média ponderada das leituras dos 5

sensores de linha.

### - O resultado indica a distância e a direção do desvio do robô em relação

ao centro da linha.

### - Se todos os sensores estiverem sobre a cor preta, a função considera

que a linha foi perdida.

### - Antes do cálculo, a função chama verifica_inversao() e, se uma

inversão for concluída, ativa a flag faixa_de_pedestre.

1 | void calcula_erro () {
2 | // Update sensor values
3 | ler_sensores () ;
4 | // Check for inversion , signaling a pedestrian crossing
5 | verifica_inversao ( SENSOR , SENSOR_CURVA );

6
7 | if ( inversao_finalizada ) {
8 | faixa_de_pedestre = true ;
9 | }

10
11 | // Initialize variables for error calculation
12 | int pesos [5] = { -2 , -1 , 0 , 1 , 2};
13 | int somatorioErro = 0;
14 | int sensoresAtivos = 0;

15
16 | // Perform a summation with the sensor values and weights
17 | for ( int i = 0; i < 5; i ++) {
18 | somatorioErro += SENSOR [ i ] * pesos [ i ];
19 | sensoresAtivos += SENSOR [ i ];
20 | }

21
22 | // Determine the car ’s error
23 | if ( sensoresAtivos == QUANTIDADE_TOTAL_SENSORES ) {

9

24 | erro = LINHA_NAO_DETECTADA ;
25 | } else {
26 | int sensoresInativos = QUANTIDADE_TOTAL_SENSORES -
| sensoresAtivos ;
27 | erro = somatorioErro / sensoresInativos ;
28 | }
29 | }
Listing 6: Cálculo do erro de posição.

## 3.7 Função calcula_PID()

Implementa o controlador PID (Proporcional-Integral-Derivativo).

- Proporcional (P): Reage proporcionalmente ao erro atual.

### - Integral (I): Acumula o erro ao longo do tempo para corrigir desvios

persistentes.

### - Derivativo (D): Responde à taxa de variação do erro para amortecer

oscilações.

### - O valor final do PID é a soma ponderada dessas três componentes e é

usado para ajustar a velocidade dos motores.

1 | void calcula_PID () {
2 | // Initialize variables for calculation
3 | PID = 0;
4 | P = erro ;
5 | I = constrain ( I + P , -255 , 255) ;
6 | D = erro - erroAnterior ;
7 | // Calculate PID
8 | PID = ( Kp * P ) + ( Ki * I ) + ( Kd * D ) + OFFSET ;
9 | // Update the previous error value
10 | erroAnterior = erro ;
11 | }
Listing 7: Cálculo do controle PID.

## 3.8 Função imprime_serial()

Envia informações de depuração para o monitor serial.

10

- Imprime o estado dos sensores de curva e de linha.
- Invoca as funções de cálculo de erro e PID e imprime seus resultados, além das velocidades resultantes dos motores.
1 | void imprime_serial () {
2 | // Print sensor values
3 | Serial . print ( SENSOR_CURVA [0]) ;
4 | Serial . print (" | ") ;

5
6 | for ( int i = 0; i < 5; i ++) {
7 | Serial . print ( SENSOR [ i ]) ;
8 | Serial . print (" | ") ;
9 | }

10
11 | Serial . print ( SENSOR_CURVA [1]) ;
12 | Serial . print (" | ") ;

13
14 | // Print Error , PID , and speed variables
15 | Serial . print ("\ tErro : ") ;
16 | calcula_erro () ;
17 | Serial . print ( erro ) ;
18 | Serial . print (" PID : ") ;
19 | calcula_PID () ;
20 | Serial . print ( PID ) ;
21 | Serial . print (" Velocidade Direita : ") ;
22 | Serial . print ( velocidadeDireita ) ;
23 | Serial . print (" Velocidade Esquerda : ") ;
24 | Serial . println ( velocidadeEsquerda ) ;
25 | }
Listing 8: Impressão de dados de depuração.

## 3.9 Função Principal loop()

### Este é o ciclo principal do programa, executado continuamente. A nova lógica é uma máquina de estados mais sofisticada para lidar com os diversos

cenários da competição.

### 3.9.1 Lógica de Competição

### - Modo Arrancada: Se arrancadaMode for verdadeiro, o robô executa

um simples seguidor de linha sem a lógica de desafios.

11

### - Modo Competição:

### 1. Leitura e Detecção: A cada ciclo, os sensores são lidos e é

verificado se há uma curva de 90 graus.
2. Faixa de Pedestres: É detectada após uma inversão de pista.

### O robô aguarda uma confirmação (contando 3 leituras de "todos

os sensores no preto") antes de executar a manobra de parada.

### 3. Seguir Linha: Se nenhuma curva for detectada e a linha estiver visível, o robô segue a pista normalmente usando o controle PID. As tentativas de recuperação de linha são resetadas após um

tempo se o robô permanecer estável.

### 4. Detecção de Curva/Desafio: Se uma curva de 90 graus é detec-

tada, o robô analisa as marcações laterais para decidir a manobra.

### – Curva Simples: Se uma ou mais marcações são vistas de apenas um lado, executa uma curva de 90 graus para esse

lado.

### – Marcha à Ré vs. Cruzamento: Se marcações são vistas

### em ambos os lados, o robô mede a diferença de tempo entre a detecção delas. Uma diferença de tempo significativa indica

uma manobra de marcha à ré. Se o tempo for muito próximo, indica um cruzamento em dúvida.

### 3.9.2 Tratamento de Exceções (Perda de Linha)

### - Tolerância: Se a linha é perdida, um contador é iniciado. A ação só é

tomada após um número de ciclos (LIMITE_TOLERANCIA_LINHA_PERDIDA) para ignorar falhas momentâneas.

- Recuperação: O robô executa a função tenta_recuperar_linha().
Se for bem-sucedido, incrementa um contador de tentativas.

### - Área de Parada: Se a recuperação falhar, ou se o número de recuper-

ações em um curto período de tempo exceder o limite (LIMITE_TENTATIVAS_RECUPERACAO),

### o robô para completamente na área de parada, considerando o percurso

finalizado.

12

### 3.9.3 Modo de Depuração

### Se a flag debugMode estiver ativa, a lógica principal é ignorada e o robô imprime continuamente os dados dos sensores no monitor serial para cali-

bração e análise.

56 | void loop () {
57 | // verifica o estado do led
58 | verifica_estado_led () ;
59 | if (! debugMode ) {
60 | if ( arrancadaMode ) {
61 | ler_sensores () ;
62 | calcula_erro () ;
63 | calcula_PID () ;
64 | ajusta_movimento () ;
65 | if ( debugSD ) write_sd (0) ;
66 | } else {
67 | ler_sensores () ;
68 | int posicao = calcula_posicao ( SENSOR ) ;
69 | if ( posicao != 0) {
70 | ultima_posicao_linha = posicao ;
71 | }
72 | // verifica se tem uma curva de 90
73 | int saidaCurva = verifica_curva_90 ( SENSOR , SENSOR_CURVA
| ) ;
74 | if (! inversaoAtiva ) {
75 | if ( saidaCurva != CURVA_NAO_ENCONTRADA && ( millis () -
| tempoUltimaCurva < DEBOUNCE_TEMPO_CURVA ) ) {
76 | saidaCurva = CURVA_NAO_ENCONTRADA ;
77 | }
78 | }

79
80 | if ( faixa_de_pedestre ) {
81 | // filtro de ruido
82 | if ( calcula_sensores_ativos ( SENSOR ) ==
| QUANTIDADE_TOTAL_SENSORES ) {
83 | qnt_fim_inversao += 1;
84 | }

85
86 | if ( qnt_fim_inversao >= 3) {
87 | if ( debugSD ) write_sd (2) ;
88 | realiza_faixa_de_pedestre () ;
89 | faixa_de_pedestre = false ;
90 | }
91 | }

92
93 | if ( saidaCurva == CURVA_NAO_ENCONTRADA ) {
94 | calcula_erro () ;

13

95 | if ( erro != LINHA_NAO_DETECTADA ) {
96 | // segue normalmente
97 | calcula_PID () ;
98 | if (( SENSOR_CURVA [0] == PRETO && SENSOR_CURVA [1] ==
| PRETO ) || inversaoAtiva ) {
99 | ajusta_movimento () ;
100 | }

101
102 | if ( millis () - tempoUltimaRecuperacao >
| TEMPO_RESET_TENTATIVAS ) {
103 | tentativasRecuperacao = 0;
104 | }

105
106 | if ( debugSD ) write_sd (0) ;
107 | contadorLinhaPerdida = 0;
108 | } else if ( erro == LINHA_NAO_DETECTADA ) {
109 | // perdeu a linha
110 | if ( contadorLinhaPerdida == 0) {
111 | tempoSemLinha = millis () ;
112 | }
113 | contadorLinhaPerdida ++;
114 | if ( contadorLinhaPerdida >
| LIMITE_TOLERANCIA_LINHA_PERDIDA || millis () -
| tempoSemLinha > 1000) {

115
116 | stop_motors () ;
117 | if ( tenta_recuperar_linha () ) {
118 | contadorLinhaPerdida = 0;
119 | tentativasRecuperacao ++;
120 | tempoUltimaRecuperacao = millis () ;

121
122 | if ( tentativasRecuperacao >=
| LIMITE_TENTATIVAS_RECUPERACAO ) {
123 | erro = erroAnterior ;
124 | if ( debugSD ) write_sd (3) ;
125 | area_de_parada () ;
126 | }
127 | } else {
128 | erro = erroAnterior ;
129 | if ( debugSD ) write_sd (3) ; // Log challenge 3:
| Stop area
130 | area_de_parada () ;
131 | }
132 | }
133 | }
134 | } else if ( saidaCurva != CURVA_NAO_ENCONTRADA ) {
135 | // evita ligar no cruzamento
136 | if ( calcula_sensores_ativos ( SENSOR ) > 1) {
137 | if (! inversaoAtiva ) {

14

138 | marcacoesDireita = 0;
139 | marcacoesEsquerda = 0;

140
141 | analisa_marcacoes () ;

142
143 | if ( marcacoesDireita == 1 && marcacoesEsquerda ==
| 1 ) {
144 | unsigned long deltaTempo ;
145 | if ( tempoMarcacaoDireita >
| tempoMarcacaoEsquerda ) {
146 | deltaTempo = tempoMarcacaoDireita -
| tempoMarcacaoEsquerda ;
147 | } else {
148 | deltaTempo = tempoMarcacaoEsquerda -
| tempoMarcacaoDireita ;
149 | }

150
151 | if ( deltaTempo >= TOLERANCIA_TEMPO_SIMULTANEO )
| {
152 | saidaCurva = ( tempoMarcacaoDireita <
| tempoMarcacaoEsquerda ) ?
153 | CURVA_DIREITA : CURVA_ESQUERDA ;
154 | realiza_marcha_re ( saidaCurva ) ;
155 | } else {
156 | turn_90 ( CURVA_EM_DUVIDA ) ;
157 | if ( debugSD ) write_sd (6) ;
158 | }
159 | } else if ( marcacoesDireita >= 1 ||
| marcacoesEsquerda >= 1) {
160 | turn_90 ( saidaCurva ) ;
161 | }
162 | }

163
164 | stop_motors () ;
165 | }
166 | }
167 | }
168 | } else {
169 | if ( debugMotor ) {
170 | test_motors () ;
171 | } else {
172 | // Get the output of the car ’s data
173 | ler_sensores () ;
174 | imprime_serial () ;
175 | }
176 | }

177
178 delay (5) ;

15

179 }
Listing 9: Loop principal de execução do robô.

# 4 Arquivo de Desafios: challenges.cpp

### Este arquivo contém a lógica para lidar com os desafios específicos da competição. Ele foi reestruturado para incluir uma máquina de estados mais robusta para a detecção de inversões e lógicas mais refinadas para cada

manobra.

## 4.1 Função verifica_estado_led()

### Uma função simples de gerenciamento que verifica se o tempo de inicial-

ização do LED (TEMPO_MAX_LED_LIGADO) já passou e, em caso afirmativo, desliga o LED.

1 | void verifica_estado_led () {
2 | if ( ledLigado ) {
3 | if ( millis () - tempoLedLigou >= TEMPO_MAX_LED_LIGADO ) {
4 | digitalWrite ( LEDS , LOW ) ;
5 | ledLigado = false ;
6 | }
7 | }
8 | }
Listing 10: Verifica e desliga o LED de status após o tempo definido.

## 4.2 Função calcula_sensores_ativos()

### Esta função auxiliar conta quantos dos cinco sensores principais de linha

estão atualmente sobre a cor preta.

1 | int calcula_sensores_ativos ( int SENSOR []) {
2 | int sensoresAtivos = 0;
3 | for (int i = 0; i < 5; i ++) {
4 | sensoresAtivos += SENSOR [ i ];
5 | }
6 | return sensoresAtivos ;

16

7 }
Listing 11: Calcula o número de sensores ativos.

## 4.3 Função verifica_curva_90()

### Analisa a combinação de leituras dos sensores para determinar se o robô encontrou uma curva de 90 graus. A lógica identifica uma curva quando pelo menos 2 sensores centrais estão ativos e um dos sensores de curva laterais

também está ativo.

1 | int verifica_curva_90 ( int SENSOR [] , int SENSOR_CURVA []) {
2 | int sensores_pretos = calcula_sensores_ativos ( SENSOR ) ;

3
4 | if ( SENSOR_CURVA [0] == PRETO && sensores_pretos >= 2 &&
| SENSOR_CURVA [1] == BRANCO ) {
5 | return CURVA_ESQUERDA ;
6 | }
7 | if ( SENSOR_CURVA [0] == BRANCO && sensores_pretos >= 2 &&
| SENSOR_CURVA [1] == PRETO ) {
8 | return CURVA_DIREITA ;
9 | }
10 | if ( SENSOR [1] == PRETO && SENSOR [3] == PRETO &&
| SENSOR_CURVA [0] == BRANCO && SENSOR_CURVA [1] == BRANCO ) {
11 | return CURVA_EM_DUVIDA ;
12 | }

13
14 | return CURVA_NAO_ENCONTRADA ;
15 | }
Listing 12: Verifica a existência de uma curva de 90 graus.

## 4.4 Função calcula_posicao()

### Calcula uma posição média ponderada da linha com base nos sensores ativos, retornando um valor entre -2 e 2. É usada para fazer pequenos ajustes

de ângulo antes de uma curva de 90 graus.

1 | int calcula_posicao ( int SENSOR []) {
2 | int pesos [5] = { -2 , -1 , 0 , 1 , 2};
3 | int somaPesos = 0 , somaAtivos = 0;

4
5 for ( int i = 0; i < 5; i ++) {

17

6 | if ( SENSOR [ i ] == PRETO ) {
7 | somaPesos += pesos [ i ];
8 | somaAtivos ++;
9 | }
10 | }

11
12 | if ( somaAtivos == 0) return 0;
13 | return somaPesos / somaAtivos ;
14 | }
Listing 13: Calcula a posição ponderada da linha.

## 4.5 Função turn_90()

### Executa a manobra de curva de 90 graus. A função avança até passar da marcação inicial, para, calcula um ângulo de giro ajustado com base na posição da linha e, após a rotação, avança novamente até se realinhar na

pista para evitar detecções duplicadas.

1 | void turn_90 (int curvaEncontrada ) {
2 | if (! inversaoAtiva ) {
3 | unsigned long startTime = millis () ;
4 | while ( calcula_sensores_ativos ( SENSOR ) <= 1) {
5 | run ( velocidadeBaseDireita , velocidadeBaseEsquerda ) ;
6 | ler_sensores () ;
7 | }
8 | delay (50) ;

9
10 | stop_motors () ;
11 | delay (100) ;
12 | int posicao = calcula_posicao ( SENSOR ) ;
13 | int ajuste = posicao * 0;
14 | int anguloFinal = 80 + ajuste ;

15
16 | stop_motors () ;
17 | delay (200) ;

18
19 | erro = erroAnterior ;
20 | if ( curvaEncontrada == CURVA_ESQUERDA ) {
21 | turn_right ( velocidadeBaseDireita ,
| velocidadeBaseEsquerda ) ;
22 | turn_until_angle ( anguloFinal ) ;
23 | } else if ( curvaEncontrada == CURVA_DIREITA ) {
24 | turn_right ( velocidadeBaseDireita ,
| velocidadeBaseEsquerda ) ;
25 | turn_until_angle ( anguloFinal ) ;

18

26 | }

27
28 | stop_motors () ;
29 | delay (100) ;
30 | while ( true ) {
31 | calcula_erro () ;
32 | calcula_PID () ;
33 | ajusta_movimento () ;
34 | if ( SENSOR_CURVA [0] == PRETO && SENSOR_CURVA [1] ==
| PRETO && SENSOR [2] == BRANCO ) {
35 | break ;
36 | }
37 | }
38 | tempoUltimaCurva = millis () ;
39 | marcacoesDireita = 0; marcacoesDireita = 0;
40 | }
41 | }
Listing 14: Executa uma curva de 90 graus aprimorada.

## 4.6 Função calibrate_gyro()

### Calibra o giroscópio medindo seu desvio (bias) enquanto o robô está parado. A média de múltiplas leituras é calculada e armazenada para corrigir

as medições futuras.

1 | float calibrate_gyro (int samples = 200) {
2 | if ( debugMode ) Serial . println (" Calibrating gyroscope ...
| Keep the robot stationary .") ;

3
4 | float sum_gz = 0;
5 | for ( int i = 0; i < samples ; i ++) {
6 | mpu . update () ;
7 | sum_gz += mpu . getGyroZ () ;
8 | delay (10) ;
9 | }

10
11 | float bias_gz = sum_gz / samples ;

12
13 | if ( debugMode ) {
14 | Serial . print (" Calibration complete . Gyroscope Bias (Gz)
| = ") ;
15 | Serial . println ( bias_gz , 4) ;
16 | }

17
18 | return bias_gz ;

19

19 }
Listing 15: Calibra o giroscópio.

## 4.7 Função turn_until_angle()

Realiza uma rotação precisa do robô até que um ângulo alvo seja atingido, utilizando o giroscópio.

1 | void turn_until_angle ( int target_angle = 90) {
2 | unsigned long previous_time = millis () ;
3 | float angle_z = 0;

4
5 | while ( abs ( angle_z ) < target_angle ) {
6 | mpu . update () ;
7 | float angular_velocity_z = mpu . getGyroZ () - gyro_bias_z ;

8
9 | unsigned long current_time = millis () ;
10 | float delta_time = ( current_time - previous_time ) /
| 1000.0;
11 | previous_time = current_time ;

12
13 | angle_z += angular_velocity_z * delta_time ;
14 | delay (10) ;
15 | }
16 | stop_motors () ;
17 | }
Listing 16: Gira o robô até um ângulo específico.

## 4.8 Função inverte_sensor()

### Inverte a lógica de um sensor (1 vira 0, 0 vira 1), permitindo que o robô

siga uma linha de cor invertida.

1 | int inverte_sensor ( int sensor ) {
2 | if ( sensor == 1) {
3 | return 0;
4 | }
5 | return 1;
6 | }
Listing 17: Inverte o valor de um sensor.

20

## 4.9 Função verifica_inversao()

### Implementa uma máquina de estados para detectar e gerenciar a travessia

de uma seção de pista com cores invertidas.

### - Entrada: Ativa o modo de inversão (inversaoAtiva) quando apenas

1 sensor de linha está ativo.

### - Durante a Inversão: Inverte a leitura de todos os sensores para que

a lógica do seguidor de linha continue funcionando.

### - Saída: Desativa o modo de inversão quando os sensores de curva e de linha indicam o fim da seção. Ao sair, ativa a flag inversao_finalizada

para sinalizar uma possível faixa de pedestres.

1 | bool verifica_inversao ( int SENSOR [] , int SENSOR_CURVA []) {
2 | int ativos = calcula_sensores_ativos ( SENSOR ) ;

3
4 | if ( ativos == 1 && ! inversaoAtiva && SENSOR_CURVA [0] ==
| BRANCO && SENSOR_CURVA [1] == BRANCO ) {
5 | inversaoAtiva = true ;
6 | tempoInversaoAtivada = millis () ;
7 | }

8
9 | if ( inversaoAtiva && millis () - tempoInversaoAtivada >
| 1000) {
10 | if ( ativos >= 3 && SENSOR_CURVA [0] == PRETO &&
| SENSOR_CURVA [1] == PRETO ) {
11 | inversaoAtiva = false ;
12 | inversao_finalizada = true ;
13 | return false ;
14 | }
15 | }

16
17 | if ( inversaoAtiva ) {
18 | for ( int i = 0; i < 5; i ++) {
19 | SENSOR [ i ] = inverte_sensor ( SENSOR [ i ]) ;
20 | }
21 | return true ;
22 | }
23 | return false ;
24 | }
Listing 18: Verifica e trata a inversão de cores da pista.

21

## 4.10 Função realiza_faixa_de_pedestre()

### Executa uma rotina robusta para a faixa de pedestres. O robô para pelo tempo definido, dá uma pequena ré para encontrar a linha novamente, se realinha sobre ela e então avança em alta velocidade para garantir a travessia

completa.

1 | void realiza_faixa_de_pedestre () {
2 | stop_motors () ;
3 | delay ( TIMEOUT_FAIXA_PEDESTRE ) ;

4
5 | unsigned long start = millis () ;
6 | while ( erro == LINHA_NAO_DETECTADA || millis () - start <
700) {
7 | ler_sensores () ;
8 | calcula_erro () ;
9 | run_backward (150 , 150) ;
10 | }
11 | stop_motors () ;

12
13 | int pos = calcula_posicao ( SENSOR ) ;
14 | if ( pos < -1) {
15 | run ( - velocidadeBaseDireita , velocidadeBaseEsquerda ) ;
16 | } else if ( pos > 1) {
17 | run ( velocidadeBaseDireita , - velocidadeBaseEsquerda ) ;
18 | }
19 | while ( SENSOR [1] != PRETO && SENSOR [2] != BRANCO && SENSOR
[3] != PRETO ) {
20 | ler_sensores () ;
21 | }
22 | stop_motors () ;
23 | delay (500) ;

24
25 | run (255 , 255) ;
26 | delay ( TIMEOUT_PERIODO_FAIXA ) ;

27
28 | // ... ( L g i c a de f i n a l i z a | o da travessia )

29
30 | inversao_finalizada = false ;
31 | }
Listing 19: Executa o desafio da faixa de pedestres com realinhamento.

22

## 4.11 Função realiza_marcha_re()

### Executa o desafio da marcha à ré. O robô para, move-se para trás em alta velocidade, para novamente, avança um pouco para se posicionar e então

realiza a curva de 90 graus para o lado determinado.

1 | void realiza_marcha_re ( int lado_da_curva ) {
2 | if ( debugSD ) write_sd (7) ;
3 | stop_motors () ;
4 | delay (1000) ;

5
6 | run_backward (255 , 255) ;
7 | delay (1200) ;

8
9 | stop_motors () ;
10 | delay (500) ;

11
12 | run ( velocidadeBaseDireita , velocidadeBaseEsquerda ) ;
13 | delay (200) ;

14
15 turn_90 ( lado_da_curva ) ;

16
17 | stop_motors () ;
18 | delay (500) ;
19 | }
Listing 20: Executa o desafio de marcha à ré.

## 4.12 Função realiza_rotatoria()

### Controla a navegação na rotatória. Após entrar, o robô segue a linha e utiliza uma lógica com flag (aguardando_realinhar) e um contador de detecção para contar as saídas de forma confiável, evitando que a mesma saída seja contada múltiplas vezes. Ao atingir a saída desejada, executa a

manobra para sair da rotatória.

1 | void realiza_rotatoria ( int saidaCurva , int saidaDesejada ) {
2 | bool aguardando_realinhar = false ;
3 | static int contador_deteccao_saida = 0;
4 | const int TOLERANCIA_SAIDA = 2;
5 | int saidaAtual = 0;

6
7 | if ( saidaCurva == SAIDA_ESQUERDA ) {
8 | turn_left ( velocidadeBaseDireita , velocidadeBaseEsquerda ) ;
9 | turn_until_angle (90) ;

23

10 | } else if ( saidaCurva == SAIDA_DIREITA ) {
11 | turn_right ( velocidadeBaseDireita , velocidadeBaseEsquerda )
;
12 | turn_until_angle (90) ;
13 | }

14
15 | while ( saidaAtual < saidaDesejada ) {
16 | calcula_erro () ;
17 | ajusta_movimento () ;

18
19 | bool saida_detectada = ( SENSOR_CURVA [0] == PRETO &&
SENSOR_CURVA [1] == BRANCO ) ;
20 | bool robo_realinhado = ( SENSOR_CURVA [0] == PRETO &&
SENSOR_CURVA [1] == PRETO ) ;

21
22 | if (! aguardando_realinhar ) {
23 | if ( saida_detectada ) {
24 | contador_deteccao_saida ++;
25 | } else {
26 | contador_deteccao_saida = 0;
27 | }
28 | if ( contador_deteccao_saida >= TOLERANCIA_SAIDA ) {
29 | saidaAtual ++;
30 | aguardando_realinhar = true ;
31 | contador_deteccao_saida = 0;
32 | }
33 | } else {
34 | if ( robo_realinhado ) {
35 | aguardando_realinhar = false ;
36 | }
37 | }
38 | }

39
40 | if ( saidaCurva == SAIDA_ESQUERDA ) {
41 | turn_right ( velocidadeBaseDireita ,
velocidadeBaseEsquerda ) ;
42 | turn_until_angle (90) ;
43 | } else {
44 | turn_left ( velocidadeBaseDireita , velocidadeBaseEsquerda
) ;
45 | turn_until_angle (90) ;
46 | }
47 | }
Listing 21: | Executa o desafio da rotatória com contagem de saídas
aprimorada.

24

## 4.13 Função tenta_recuperar_linha()

### Rotina de recuperação executada quando a linha é perdida. O robô move-se para trás por um tempo limite (TIME_WITHOUT_LINE), procurando pela linha. Para confirmar que a linha foi reencontrada, exige 3 leituras consecu-

tivas válidas.

1 | bool tenta_recuperar_linha () {
2 | unsigned long tempoPerdido = millis () ;
3 | int leiturasValidas = 0;

4
5 | while ( millis () - tempoPerdido < TIME_WITHOUT_LINE ) {
6 | run_backward ( velocidadeBaseDireita ,
| velocidadeBaseEsquerda ) ;
7 | delay (50) ;
8 | ler_sensores () ;

9
10 | if ( SENSOR [1] == PRETO || SENSOR [2] == PRETO || SENSOR [3]
| == PRETO ) {
11 | leiturasValidas ++;
12 | if ( leiturasValidas >= 3) {
13 | stop_motors () ;
14 | return true ;
15 | }
16 | } else {
17 | leiturasValidas = 0;
18 | }
19 | }
20 | return false ;
21 | }
Listing 22: Tenta recuperar a linha movendo-se para trás.

## 4.14 Função conta_marcacao()

### Realiza a contagem de marcadores (quadrados pretos). A lógica foi aprimorada para contar na transição para o branco e exigir um número mínimo de leituras (TOLERANCIA_MARCACAO) para evitar ruídos, garantindo que cada

marcador seja contado apenas uma vez.

1 | int conta_marcacao ( int estadoSensor , int contagemAtual , bool
| & jaContou , int & contadorBranco , unsigned long & tempoMarcacao ) {
2 | if ( calcula_sensores_ativos ( SENSOR ) <= 1) return
| contagemAtual ;

25

3 | if ( marcacoesDireita >= 1 && marcacoesEsquerda >= 1) return
| contagemAtual ;

4
5 | if ( estadoSensor == BRANCO ) {
6 | contadorBranco ++;
7 | if ( contadorBranco >= TOLERANCIA_MARCACAO && ! jaContou ) {
8 | jaContou = true ;
9 | tempoMarcacao = millis () ;
10 | return contagemAtual + 1;
11 | }
12 | } else {
13 | contadorBranco = 0;
14 | jaContou = false ;
15 | }
16 | return contagemAtual ;
17 | }
Listing 23: Contagem de marcadores de pista com filtro de ruído.

## 4.15 Função analisa_marcacoes()

### Orquestra a detecção de desafios. Ela entra em um loop por um tempo definido (TIMEOUT_MARCACAO) após a detecção de uma curva, chamando conta_marcacao para registrar os marcadores de cada lado e seus respectivos tempos de de-

tecção.

1 | void analisa_marcacoes () {
2 | if (! inversaoAtiva ) {
3 | unsigned long tempoUltimaDeteccao = millis () ;
4 | jaContouEsquerda = false ;
5 | jaContouDireita = false ;

6
7 | while (( millis () - tempoUltimaDeteccao < TIMEOUT_MARCACAO )
| ) {
8 | ler_sensores () ;

9
10 | static int contadorBrancoEsq = 0;
11 | static int contadorBrancoDir = 0;

12
13 | int marcacoesAntesEsq = marcacoesEsquerda ;
14 | int marcacoesAntesDir = marcacoesDireita ;

15
16 | marcacoesEsquerda = conta_marcacao ( SENSOR_CURVA [0] ,
| marcacoesEsquerda , jaContouEsquerda , contadorBrancoEsq ,
| tempoMarcacaoEsquerda ) ;

26

17 | marcacoesDireita | = conta_marcacao ( SENSOR_CURVA [1] ,
marcacoesDireita , jaContouDireita , contadorBrancoDir , tempoMarcacaoDireita ) ;

18
19 | if ( marcacoesEsquerda > marcacoesAntesEsq ||
marcacoesDireita > marcacoesAntesDir ) {
20 | tempoUltimaDeteccao = millis () ;
21 | }

22
23 | if ( marcacoesDireita >= 1 && marcacoesEsquerda >= 1) {
24 | marcacoesDireita = 1;
25 | marcacoesEsquerda = 1;
26 | }
27 | calcula_erro () ;
28 | calcula_PID () ;
29 | ajusta_movimento () ;
30 | }
31 | }
32 | }
Listing 24: Analisa e conta marcadores de pista por um tempo determinado.

## 4.16 Função area_de_parada()

### Função final que é chamada quando o robô não consegue se recuperar de

uma perda de linha ou atinge o limite de tentativas. Ele avança um pouco,

### para os motores, acende o LED e entra em um loop infinito, finalizando o

percurso.

1 | void area_de_parada () {
2 | run ( velocidadeBaseDireita - 5 , velocidadeBaseEsquerda ) ;
3 | delay (1000) ;
4 | stop_motors () ;
5 | digitalWrite ( LEDS , HIGH ) ;
6 | tempoLedLigou = millis () ;
7 | ledLigado = true ;
8 | if ( debugSD ) write_sd (3) ; // Log challenge 3: Stop area
9 | while ( true );
10 | }
Listing 25: Finaliza o percurso na área de parada.

27

# 5 Arquivo de Controle dos Motores: motors.cpp

### Este arquivo representa a camada de abstração de hardware para o controle dos motores do robô. Ele é responsável por inicializar os pinos do microcontrolador e fornecer uma interface simples para executar movimentos

básicos como andar para frente, para trás, girar e parar.

## 5.1 Função setup_motor()

Inicializa os pinos de controle dos motores como saídas.

1 | void setup_motor () {
2 | pinMode ( MOTOR_LEFT_CLKWISE , OUTPUT ) ;
3 | pinMode ( MOTOR_LEFT_ANTI , OUTPUT ) ;
4 | pinMode ( MOTOR_RIGHT_CLKWISE , OUTPUT ) ;
5 | pinMode ( MOTOR_RIGHT_ANTI , OUTPUT ) ;
6 | stop_motors () ;
7 | }
Listing 26: Configuração inicial dos pinos dos motores.

## 5.2 Função set_state_motor()

### Função de baixo nível que aplica diretamente os valores de PWM (0-255)

aos pinos de controle dos motores.

1 | void set_state_motor ( int leftCw , int leftCcw , int rightCw ,
| int rightCcw ) {
2 | analogWrite ( MOTOR_LEFT_CLKWISE , leftCw ) ;
3 | analogWrite ( MOTOR_LEFT_ANTI , leftCcw );
4 | analogWrite ( MOTOR_RIGHT_CLKWISE , rightCw ) ;
5 | analogWrite ( MOTOR_RIGHT_ANTI , rightCcw ) ;
6 | }
Listing 27: Define o estado e a velocidade de cada motor.

28

# 6 Arquivo de Constantes e Variáveis Globais:

# constants.cpp

### Este arquivo centraliza todas as constantes e variáveis globais. Essa abordagem facilita o ajuste de parâmetros e o gerenciamento de estados do robô

sem alterar a lógica principal.

## 6.1 Pinos e Hardware

### Define as conexões físicas dos sensores, LEDs e o pino Chip Select para

o cartão SD.

## 6.2 Variáveis de Estado dos Sensores

### Arrays que armazenam as leituras dos sensores de linha (SENSOR) e de

curva (SENSOR_CURVA).

## 6.3 Configurações de Velocidade e Motores

### - velocidadeBase: A velocidade padrão, que é mais alta (255) no modo

de arrancada e menor (210) no modo de competição.

### - OFFSET_MOTORS: Um valor de ajuste para compensar diferenças mecâni-

cas entre os motores, garantindo um movimento reto.

- velocidadeDireita, velocidadeEsquerda: Variáveis que armazenam a velocidade ajustada pelo PID.

## 6.4 Controle PID

- Ganhos: Kp, Ki, Kd. Notavelmente, no modo de arrancada (arrancadaMode),

### os ganhos Ki e Kd são zerados, transformando o controle em um sistema

puramente Proporcional, mais simples e agressivo.

### - Variáveis de Cálculo: erro, P, I, D, PID, etc., usadas para o cálculo

em tempo de execução.

29

## 6.5 Variáveis de Estado dos Desafios

Flags e contadores que gerenciam o estado do robô durante a competição.

### - inversaoAtiva: Flag que indica se o robô está em uma seção de pista

invertida.

### - inversao_finalizada: Flag ativada ao sair de uma inversão, sinal-

izando uma possível faixa de pedestres.

- marcacoesDireita, marcacoesEsquerda: Contadores para os marcadores de desafio.
- tempoMarcacaoDireita, tempoMarcacaoEsquerda: Armazenam o millis()

### no momento da detecção de um marcador, usado para diferenciar de-

safios.

### - ultima_posicao_linha: Guarda a última posição válida da linha para

auxiliar na recuperação.

## 6.6 Controle de Depuração (Debug)

Flags booleanas para ativar diferentes modos de teste.

- debugMode: Ativa a impressão de dados no monitor serial.
- debugMotor: Ativa um teste de motores no loop().
- debugSD: Habilita a gravação de logs no cartão SD.

### - arrancadaMode: Ativa um modo de performance simplificado, com

maior velocidade e controle apenas Proporcional.

## 6.7 Parâmetros de Tolerância e Tempo

Constantes que definem o comportamento temporal do robô.

- TIMEOUT_FAIXA_PEDESTRE: Tempo de parada na faixa.

30

### - TIMEOUT_MARCACAO: Duração da janela de tempo para analisar os mar-

cadores de um desafio.

### - DEBOUNCE_TEMPO_CURVA: Tempo de espera para evitar a detecção dupla

de uma mesma curva.

### - TOLERANCIA_TEMPO_SIMULTANEO: Limiar de tempo para diferenciar uma

marcha à ré de um cruzamento.

- LIMITE_TOLERANCIA_LINHA_PERDIDA: Número de ciclos de "linha perdida" antes de iniciar a recuperação.

# 7 Script de Análise e Visualização: plot_log.py

Para auxiliar no processo de calibração do controlador PID, foi desenvolvido um script em Python, o plot_log.py. Esta ferramenta permite analisar os arquivos de log .TXT gerados pelo robô, visualizar o desempenho em gráficos detalhados e, mais importante, simular o comportamento do robô com diferentes constantes PID sem a necessidade de realizar um novo percurso físico. O script recalcula a saída do PID com base no histórico de erros e nos novos ganhos fornecidos pelo usuário, oferecendo também sugestões

automáticas para otimização.

## 7.1 Função calculate_pid_values()

Esta é a função central da simulação. Ela itera sobre cada registro de erro do arquivo de log e recalcula, linha por linha, quais teriam sido os termos Proporcional, Integral e Derivativo e a saída final do PID se as novas constantes Kp, Ki e Kd tivessem sido usadas. A lógica, incluindo a restrição do

termo integral, espelha exatamente o comportamento do microcontrolador.

1 | def calculate_pid_values (df , Kp , Ki , Kd ) :
2 | pid_values = []
3 | I = 0
4 | erroAnterior = 0
5 | OFFSET = 0

6
7 | for erro in df [’Error ’]:
8 | P = erro
9 | I = I + P

31

10 | # Constrain the integral term , similar to the Arduino
| code
11 | I = max ( -255 , min (255 , I ))
12 | D = erro - erroAnterior

13
14 | p_term_val = Kp * P
15 | i_term_val = Ki * I
16 | d_term_val = Kd * D

17
18 | PID = p_term_val + i_term_val + d_term_val + OFFSET
19 | pid_values . append ( PID )

20
21 | erroAnterior = erro

22
23 | return pd . DataFrame ({ ’PID ’: pid_values })
Listing 28: Recalcula a saída do PID com novas constantes.

## 7.2 Função plot_data()

### Esta função é responsável por gerar a visualização gráfica dos dados. Ela cria uma janela com quatro gráficos sobrepostos:

### - Erro vs. Tempo: Mostra o desvio do robô em relação à linha, incluindo marcadores para os desafios da competição. Uma curva de erro suavizada (usando um filtro Savitzky-Golay) é sobreposta para mostrar

a tendência geral do percurso.

### - Erro Suavizado vs. Tempo: Apresenta a curva de erro suavizada

para uma visualização mais clara da trajetória.

### - Saída do PID vs. Tempo: Exibe o valor de correção calculado pelo

PID.

### - Velocidade dos Motores vs. Tempo: Mostra como a saída do PID

foi traduzida para a velocidade de cada motor.

1 | def plot_data ( df , Kp , Ki , Kd ) :
2 | fig , ( ax1 , ax2 , ax3 , ax4 ) = plt . subplots (4 , 1 , figsize
| =(14 , 12) , sharex = True )
3 | fig . suptitle ( f" Analysis of PID Control with Kp ={ Kp} , Ki ={
| Ki} , Kd ={ Kd}", fontsize =16)

4

32

5 | try :
6 | window_length = min (51 , len ( df [’Error ’]) )
7 | if window_length % 2 == 0:
8 | window_length -= 1

9
10 | if window_length > 3:
11 | df [’ Smoothed_Error ’] = savgol_filter ( df [’Error ’
| ] , window_length , 3)
12 | else :
13 | df [’ Smoothed_Error ’] = df [’Error ’]
14 | except Exception :
15 | df [’ Smoothed_Error ’] = df [’Error ’]

16
17 | ax1 . plot ( df [’Time ’] , df [’Error ’] , | marker =’o’, label =’
Error ( Actual Path )’, color =’blue ’, alpha =0.4)
18 | ax1 . plot ( df [’Time ’] , df [’ Smoothed_Error ’] , label =’
Smoothed Trend ’, color =’green ’, linewidth =2.5)
19 | ax1 . axhline (0 , color =’k’, linestyle =’--’, linewidth =1 ,
| label =’Ideal Path ( Error =0) ’)

20
21 | if ’Challenge ’ in df . columns and not df [ df [’Challenge ’]
| != 0]. empty :
22 | challenges = df [ df [’Challenge ’] != 0]
23 | plotted_labels = set ()

24
25 | for _ , row in challenges . iterrows () :
26 | challenge_code = int ( row [’Challenge ’])
27 | if challenge_code in challenge_map :
28 | props = challenge_map [ challenge_code ]
29 | label = props [’label ’]

30
31 | current_label = label if label not in
| plotted_labels else ""

32
33 | ax1 . scatter ( row [’Time ’] , row [’Error ’] ,
34 | label = current_label ,
35 | color = props [’color ’] ,
36 | marker = props [’marker ’] ,
37 | s = props [’size ’] ,
38 | zorder =5)
39 | plotted_labels . add ( label )

40
41 | ax1 . set_title (’Error vs Time ’)
42 | ax1 . legend ( loc =’center left ’, bbox_to_anchor =(1 , 0.5) )

43
44 | ax2 . plot ( df [’Time ’] , df [’ Smoothed_Error ’] , label =’
Smoothed_Error ’, color =’green ’, linewidth =2.5)
45 | ax2 . set_title (’ Smoothed_Error vs Time ’)

46

33

47 | ax3 . plot ( df [’Time ’] , df [’PID ’] , label =’Total PID Output ’,
| color =’red ’)
48 | ax3 . set_title (’PID Output vs Time ’)

49
50 | ax4 . plot ( df [’Time ’] , df [’Velocidade Direita ’], label =’
| Velocidade Direita ’, color =’purple ’)
51 | ax4 . plot ( df [’Time ’] , df [’Velocidade Esquerda ’] , label =’
| Velocidade Esquerda ’, color =’orange ’)
52 | ax4 . set_title (’Velocidade dos Motores vs. Tempo ’)

53
54 | plt . tight_layout ( rect =[0 , 0.03 , 0.85 , 0.95])
55 | plt . show ()
Listing 29: Gera os gráficos de análise de desempenho.

## 7.3 Função analyze_performance_and_suggest_pid()

Após a visualização dos gráficos, esta função realiza uma análise quantitativa do desempenho do robô. Ela calcula métricas como o erro médio absoluto (MAE), o erro máximo (overshoot) e o número de oscilações (usando detecção de picos). Com base nessas métricas, ela imprime no terminal um diagnóstico do comportamento do robô e sugere ações claras para o ajuste

dos ganhos PID, automatizando o processo de calibração.

1 | def analyze_performance_and_suggest_pid ( df , Kp , Ki , Kd ) :
2 | print ("\n- -- A n l i s e de Desempenho & S u g e s t e s de
Ajuste ---")

3
4 | error = df [’Error ’]. to_numpy ()
5 | mae = np . mean ( np . abs ( error ) )
6 | max_abs_error = np . max ( np . abs ( error ) )

7
8 | peaks , _ = find_peaks ( error , prominence =0.5)
9 | troughs , _ = find_peaks ( - error , prominence =0.5)
10 | num_oscillations = len ( peaks ) + len ( troughs )

11
12 | print ( f" Erro M d i o Absoluto ( MAE ): { mae :.4 f}")
13 | print ( f" M x i m o Erro Absoluto ( Overshoot / Undershoot ): {
| max_abs_error :.4 f}")
14 | print ( f" Detectadas { num_oscillations } o s c i l a | e s
| significativas .")

15
16 | print ("\ n S u g e s t e s :")
17 | suggestion_made = False

18
19 | if num_oscillations > 8:

34

20 | print ("- Comportamento Detectado : O r o b | oscila
muito ... ")
21 | print ( f" | - A | o | Recomendada : Diminua o valor de Kp
( atual : {Kp }).")
22 | suggestion_made = True

23
24 | # ... ( l g i c a para outras s u g e s t e s ) ...

25
26 | if not suggestion_made :
27 | print ("- O desempenho parece r a z o v e l .")
Listing 30: Analisa métricas e sugere ajustes para o PID.

## 7.4 Exemplo de Saída Gráfica

A Figura 1 ilustra a janela de análise gerada pelo script plot_log.py.

É possível observar o comportamento do erro (gráfico superior), a saída do controlador PID (gráfico intermediário) e a velocidade resultante dos motores (gráfico inferior). Os marcadores coloridos no primeiro gráfico indicam os exatos momentos em que eventos da competição ocorreram, como a detecção de

uma ‘linhainvertida‘(quadradoazul), amanobrada‘F aixadeP edestre‘(quadradolaranja)ea‘readeP arada‘(pontolaranja).


Figure 1: Exemplo da janela de análise gerada pelo script plot_log.py.

35

# 8 Referências Bibliográficas

## 8.1 Controle PID

O Controle PID (Proporcional Integral Derivativo) é usado para o controle de processos. O seu objetivo é apartir de equações matematicas que envolvem integrais e derivadas, minimizar o erro do sistema. O controle proporcional ajusta a variável de controle de forma proporcional ao erro. O controle integral ajusta a variável de controle baseando-se no tempo em que o erro acontece. O controle derivativo ajusta a variável de controle tendo como base

a taxa de variação do erro.

### Equação do controle PID:

### P ID(t) = Kpe(t) + Ki

Z t

0

### e(τ ) dτ + Kd

d
dte(t) | (1)

### Nessa equação, temos os seguintes parâmetros:

- Kp: ganho proporcional;
- Ki

: ganho integral;

- Kd: ganho derivativo;
- e: erro instantâneo (diferença entre o valor desejado e o valor medido);
- τ : variável de integração;
- t: tempo atual.

### Abaixo há uma tabela explicando como se deve ajustar os parametros do

PID conforme o erro que o robô apresenta.

36

Comportamento do Robô | Parâmetro a Ajus-tar | Ação Recomendada
Oscila muito em torno da linha (zig-zag) | Proporcional (Kp) | Diminua o valor de Kp. Um Kp muito alto causa reações exageradas.
Corrige devagar e não consegue seguir bem a linha | Proporcional (Kp) | Aumente o valor de Kp. Um Kp muito baixo gera correções fracas.
Erro pequeno persiste por muito tempo | Integral (Ki) | Aumente Ki para corrigir erros acumu-lados lentamente.
Começa a oscilar após um tempo seguindo bem | Integral (Ki) | Diminua Ki. Um Ki alto pode acumu-lar erro demais e causar instabilidade.
Reação muito abrupta a mudanças rápidas na linha | Derivativo (Kd) | Aumente Kd para suavizar a resposta. Ele ajuda a "frear" mudanças bruscas.
Resposta lenta a mudanças rápidas | Derivativo (Kd) | Diminua Kd se o robô demorar demais para reagir a curvas ou desvios.

### Table 1: Ajuste dos parâmetros do PID com base no comportamento do robô

# 9 Conclusão

Este documento apresenta a estrutura e as funcionalidades do código,

### facilitando o entendimento do sistema e promovendo a democratização do mesmo. Ele proporciona liberdade e autonomia para a realização de testes e a utilização do código em diferentes contextos, permitindo uma maior flexi-

bilidade no desenvolvimento e aprimoramento do projeto.

37
