lemosslucas/CoRA2025/miscellaneous/motor_mount.pdf

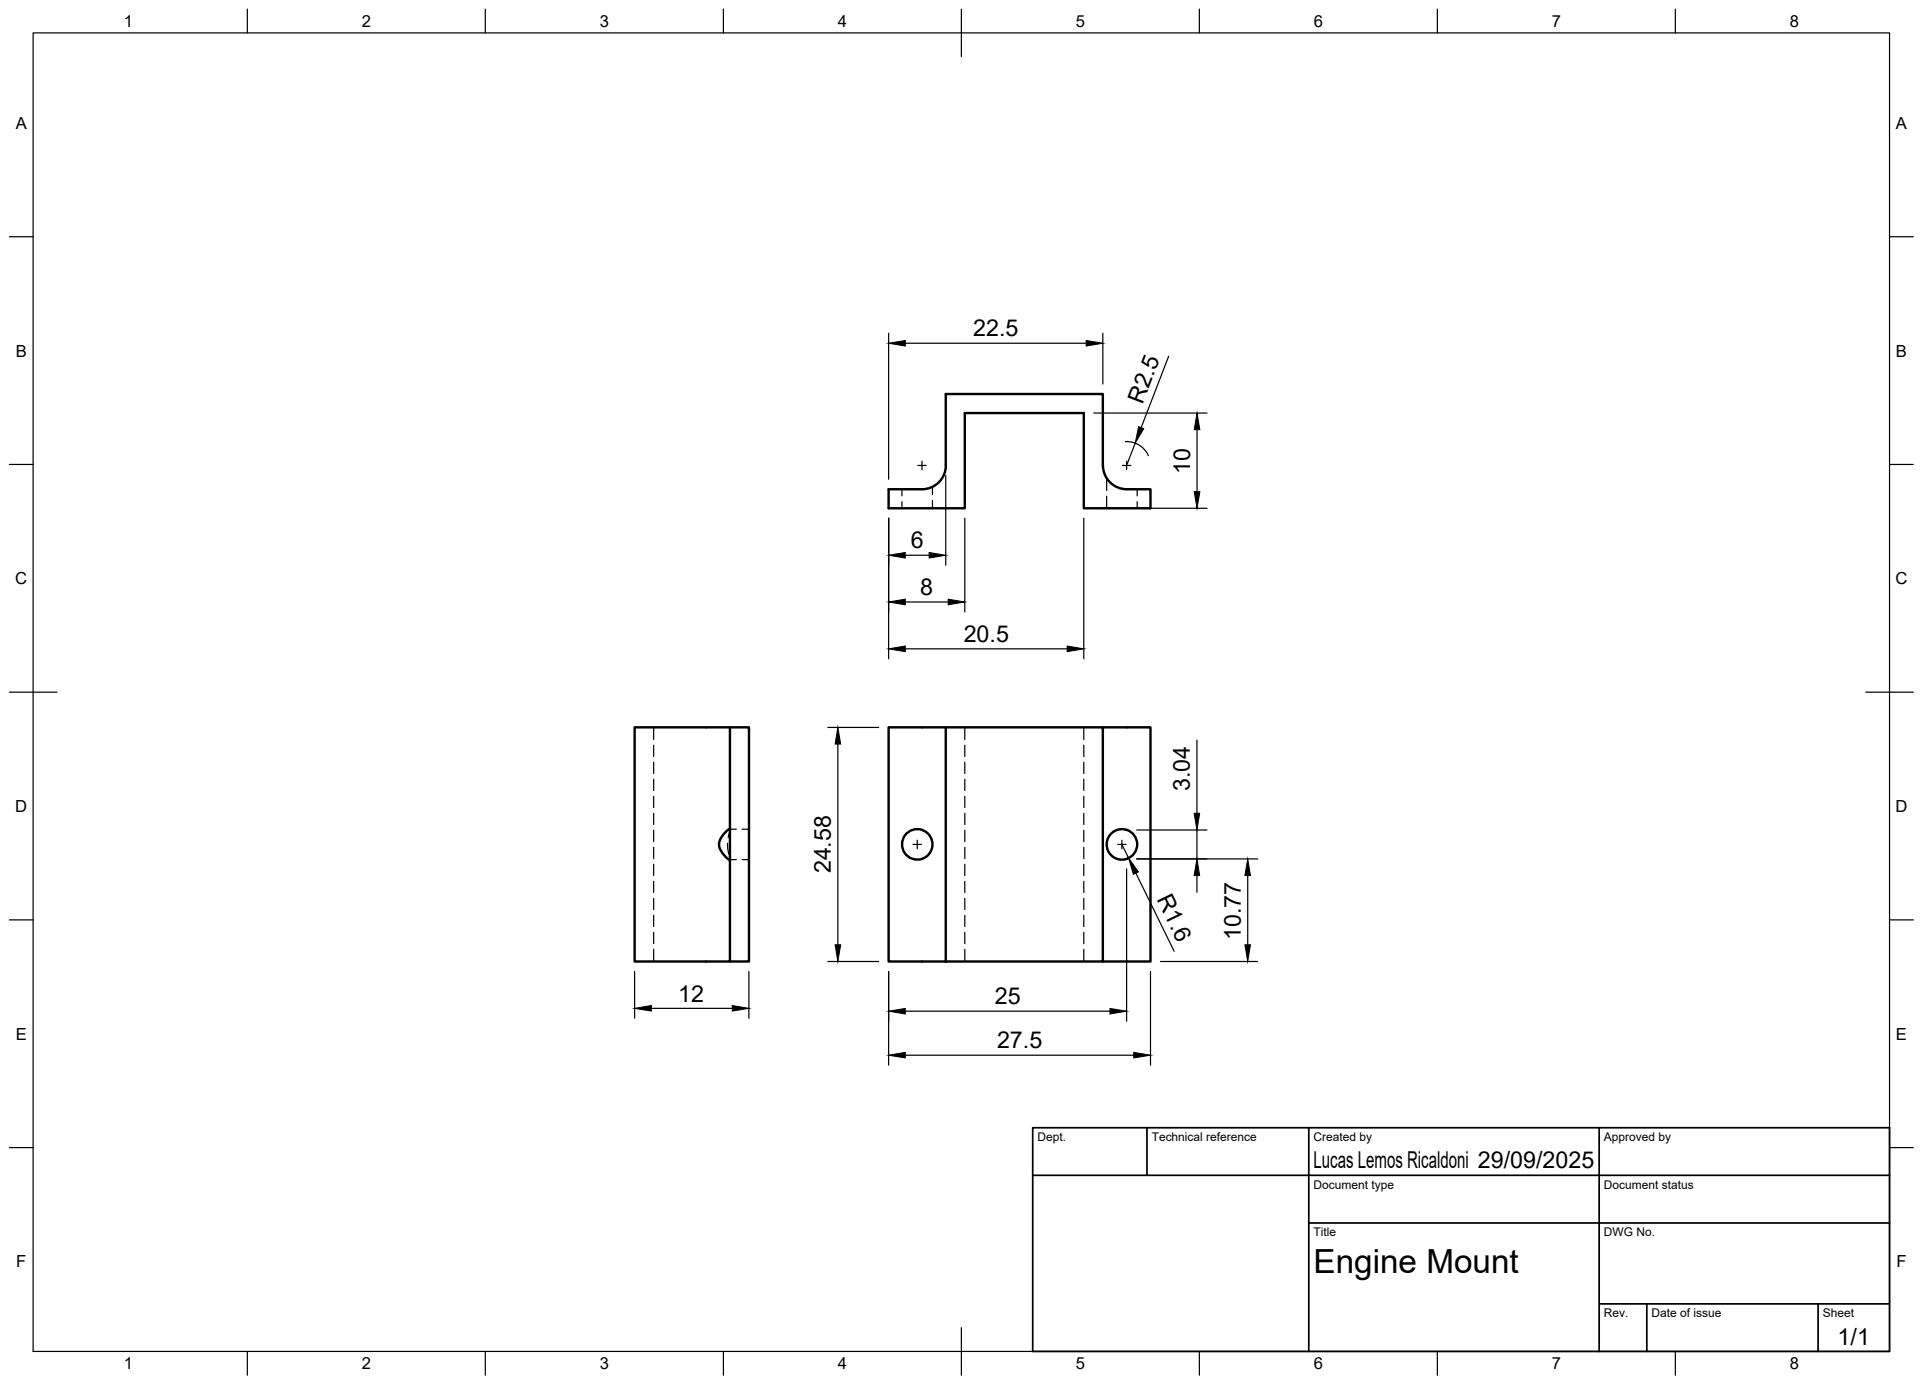
[picture p5: page 1]
Title; DWG No.; Rev.; Date of issue; Sheet; Engine Mount

Dept. | Technical reference | Created by Lucas Lemos Ricaldoni 29/09/2025 | Approved by

Document type | Document status
