lemosslucas/CoRA2025/miscellaneous/bms_box.pdf

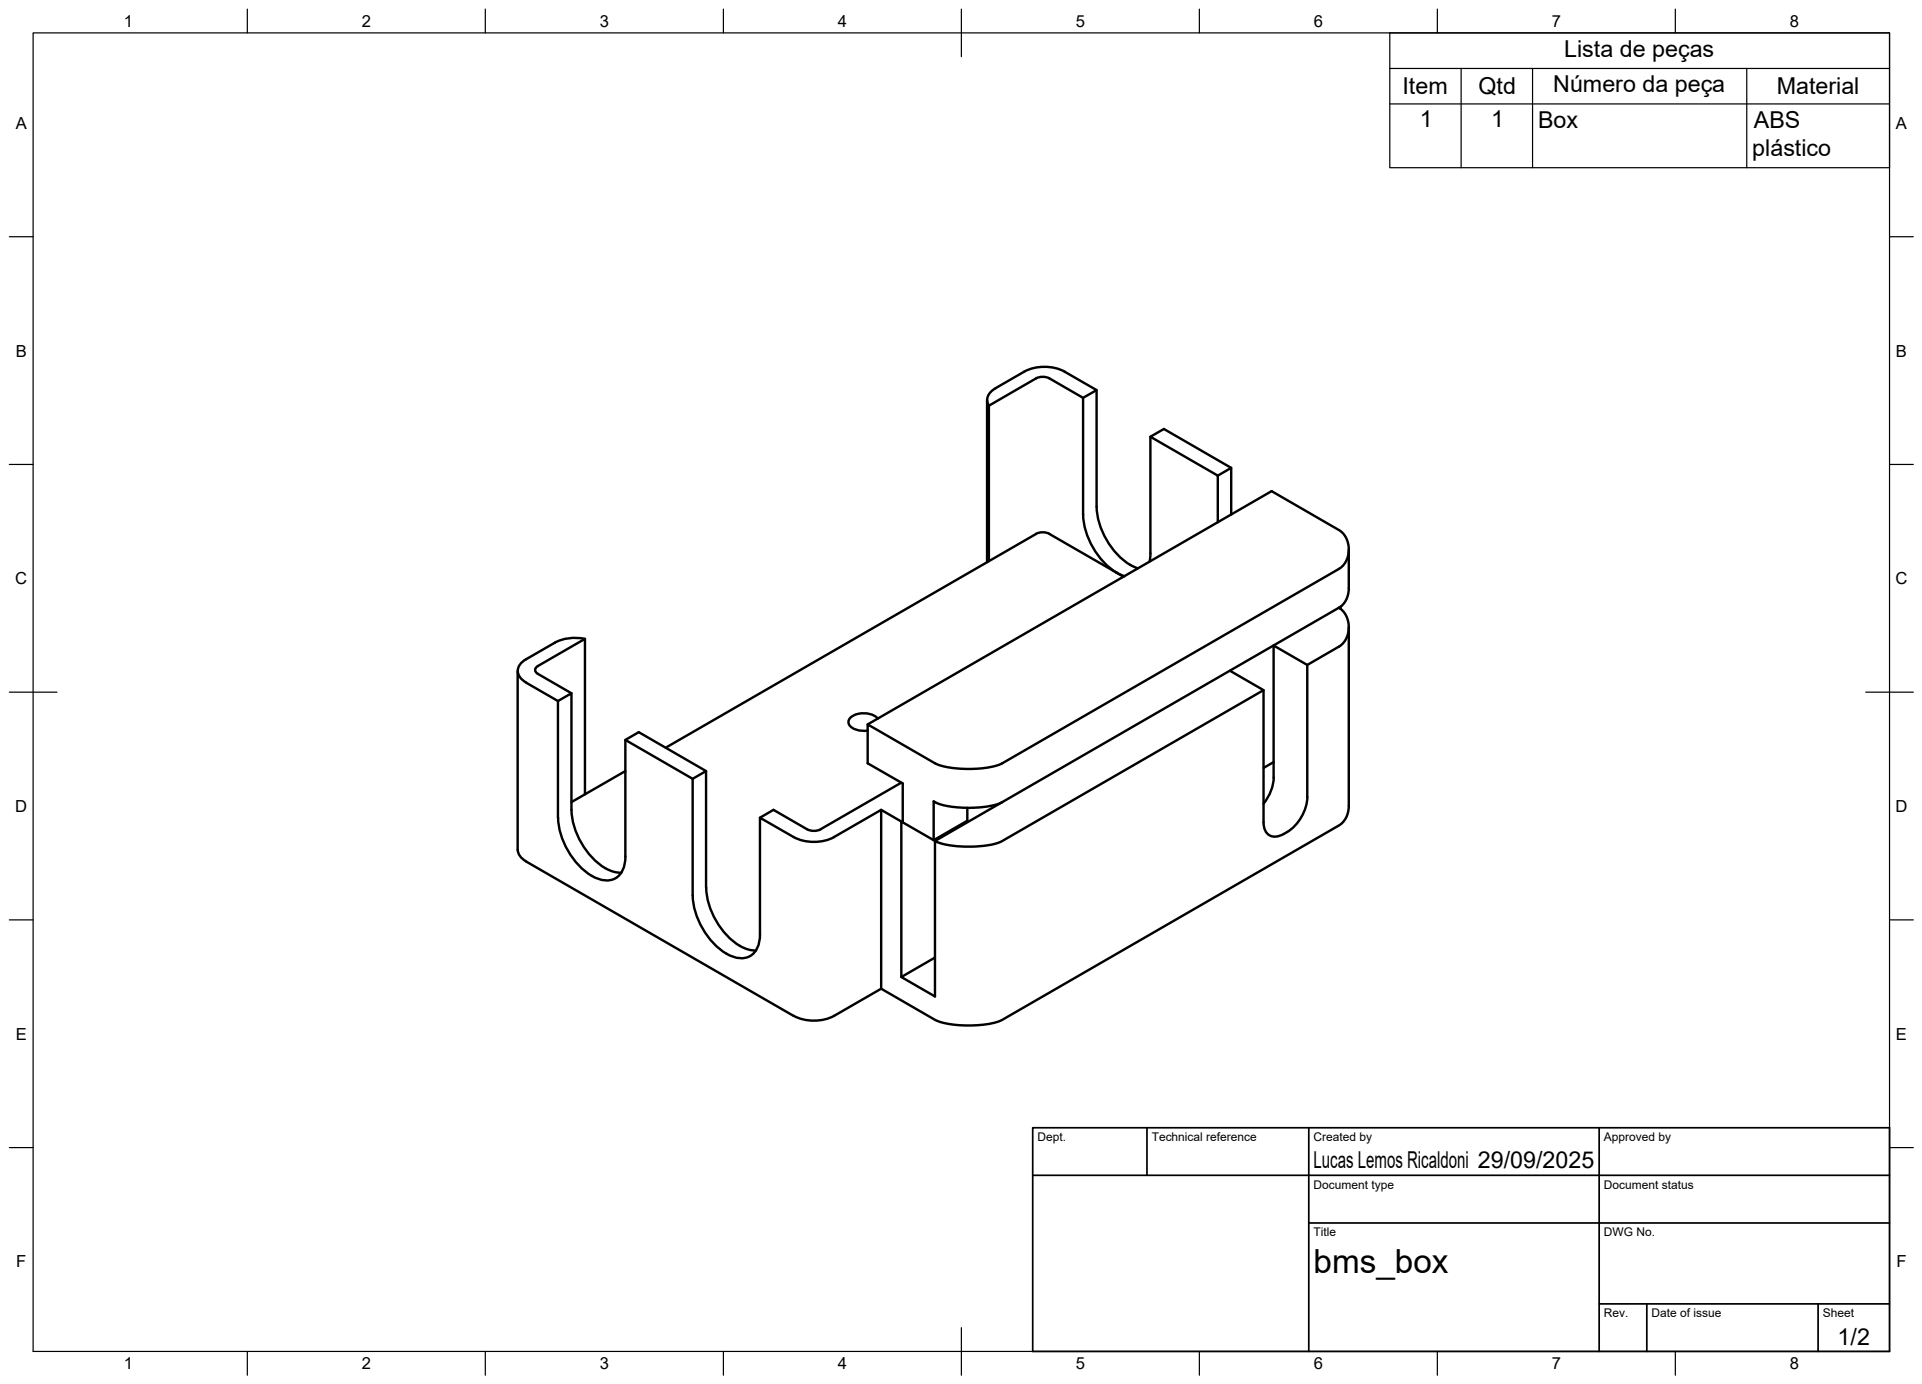
[picture p6: page 1]
Title; DWG No.; Rev.; Date of issue; Sheet

Lista de peças

Item | Qtd | Número da peça | Material
1 | 1 | Box | ABS plástico

Dept. | Technical reference | Created by Lucas Lemos Ricaldoni 29/09/2025 | Approved by

Document type | Document status

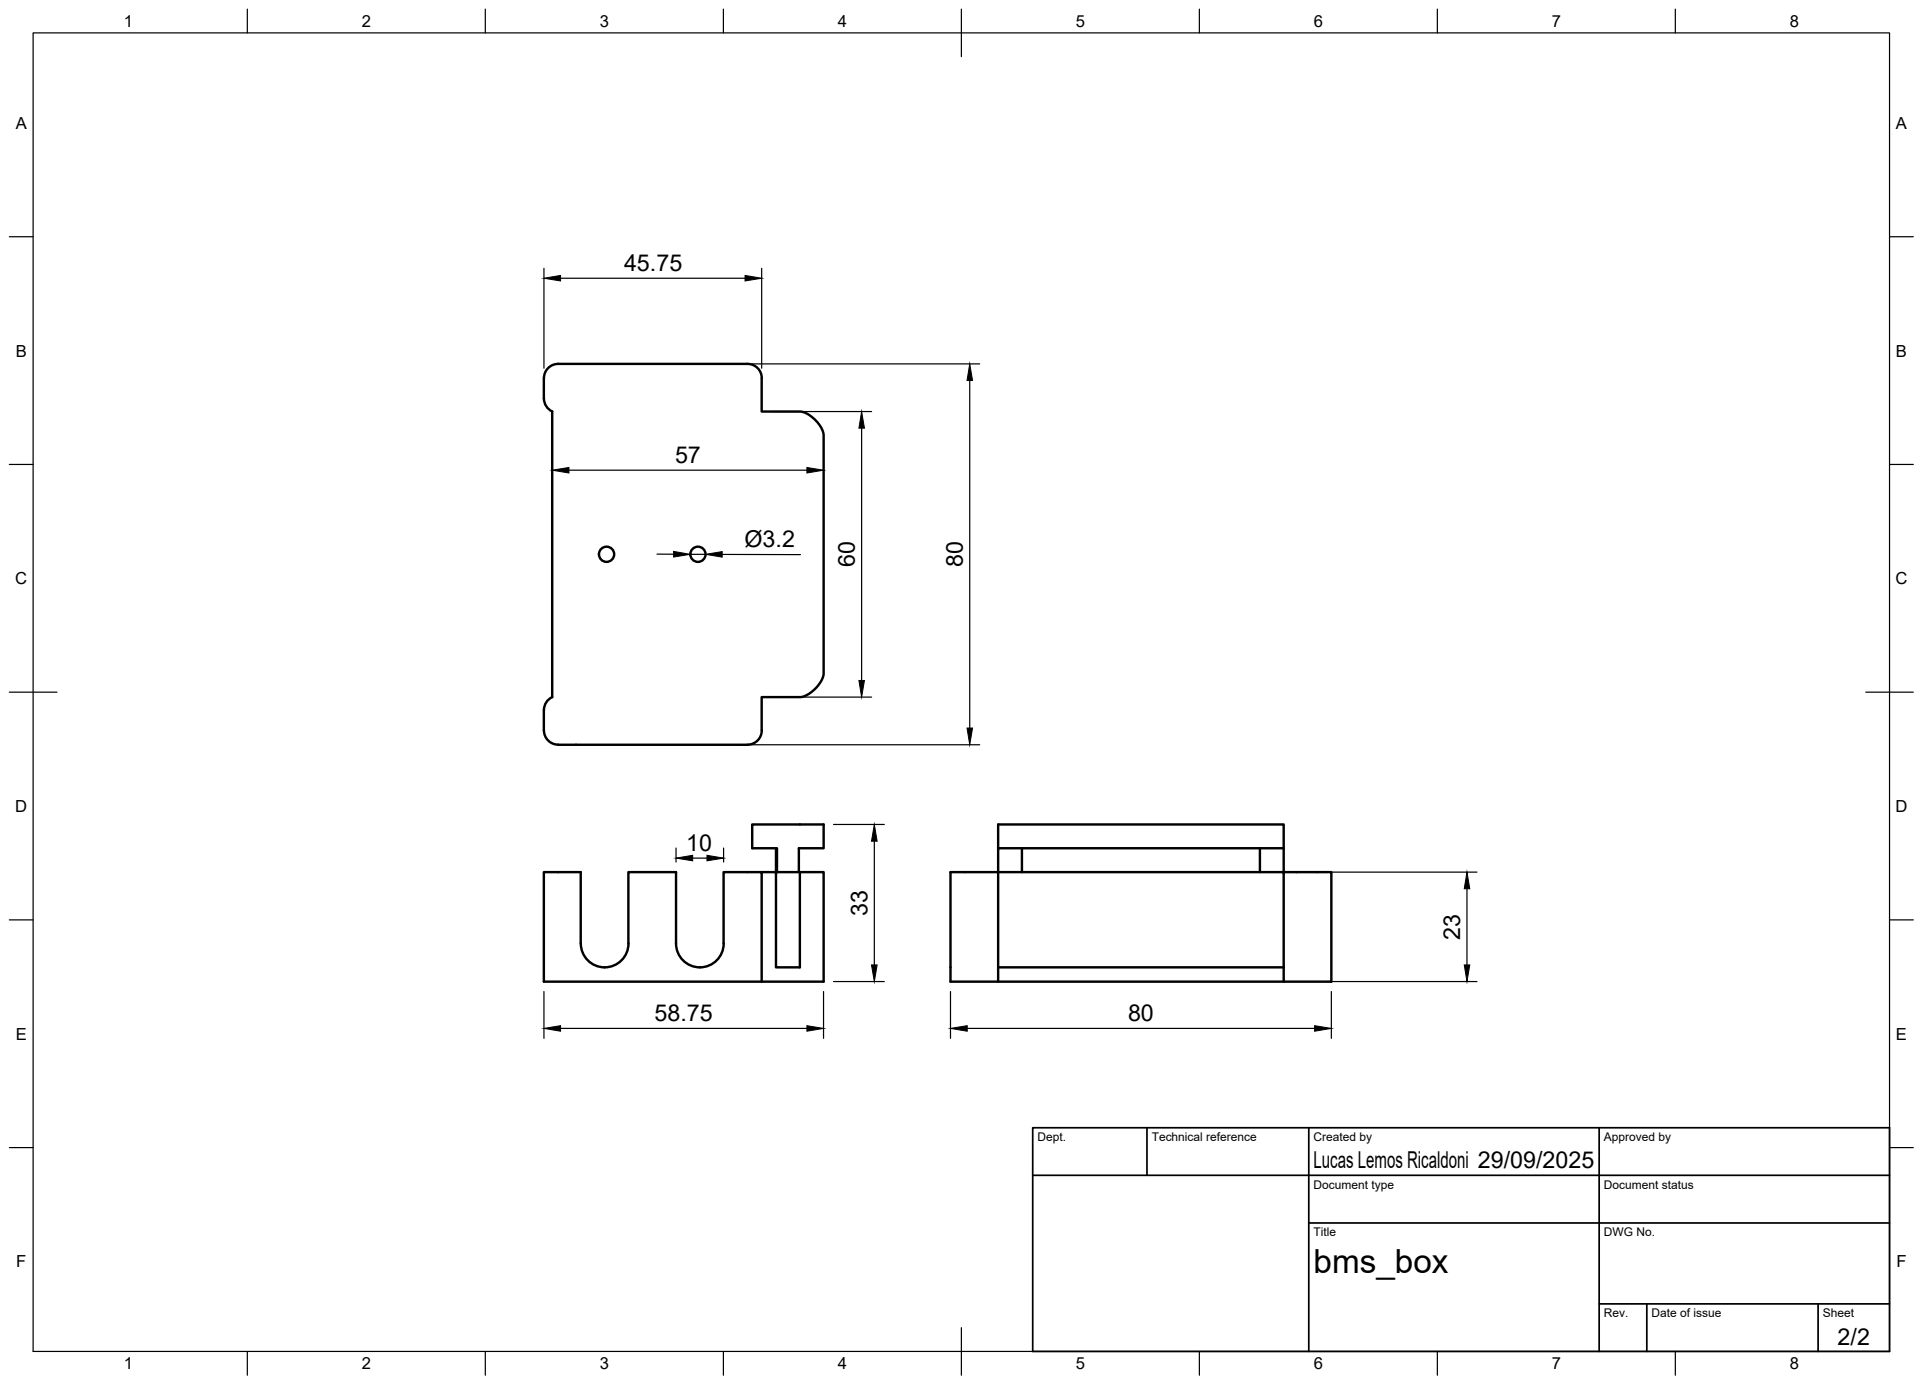
[picture p7: page 2]
Title; DWG No.; Rev.; Date of issue; Sheet

Dept. | Technical reference | Created by Lucas Lemos Ricaldoni 29/09/2025 | Approved by

Document type | Document status
