lemosslucas/CoRA2025/miscellaneous/chassi.pdf

A

2 | 3 | 4 | 5 | 6 | 7 | 8

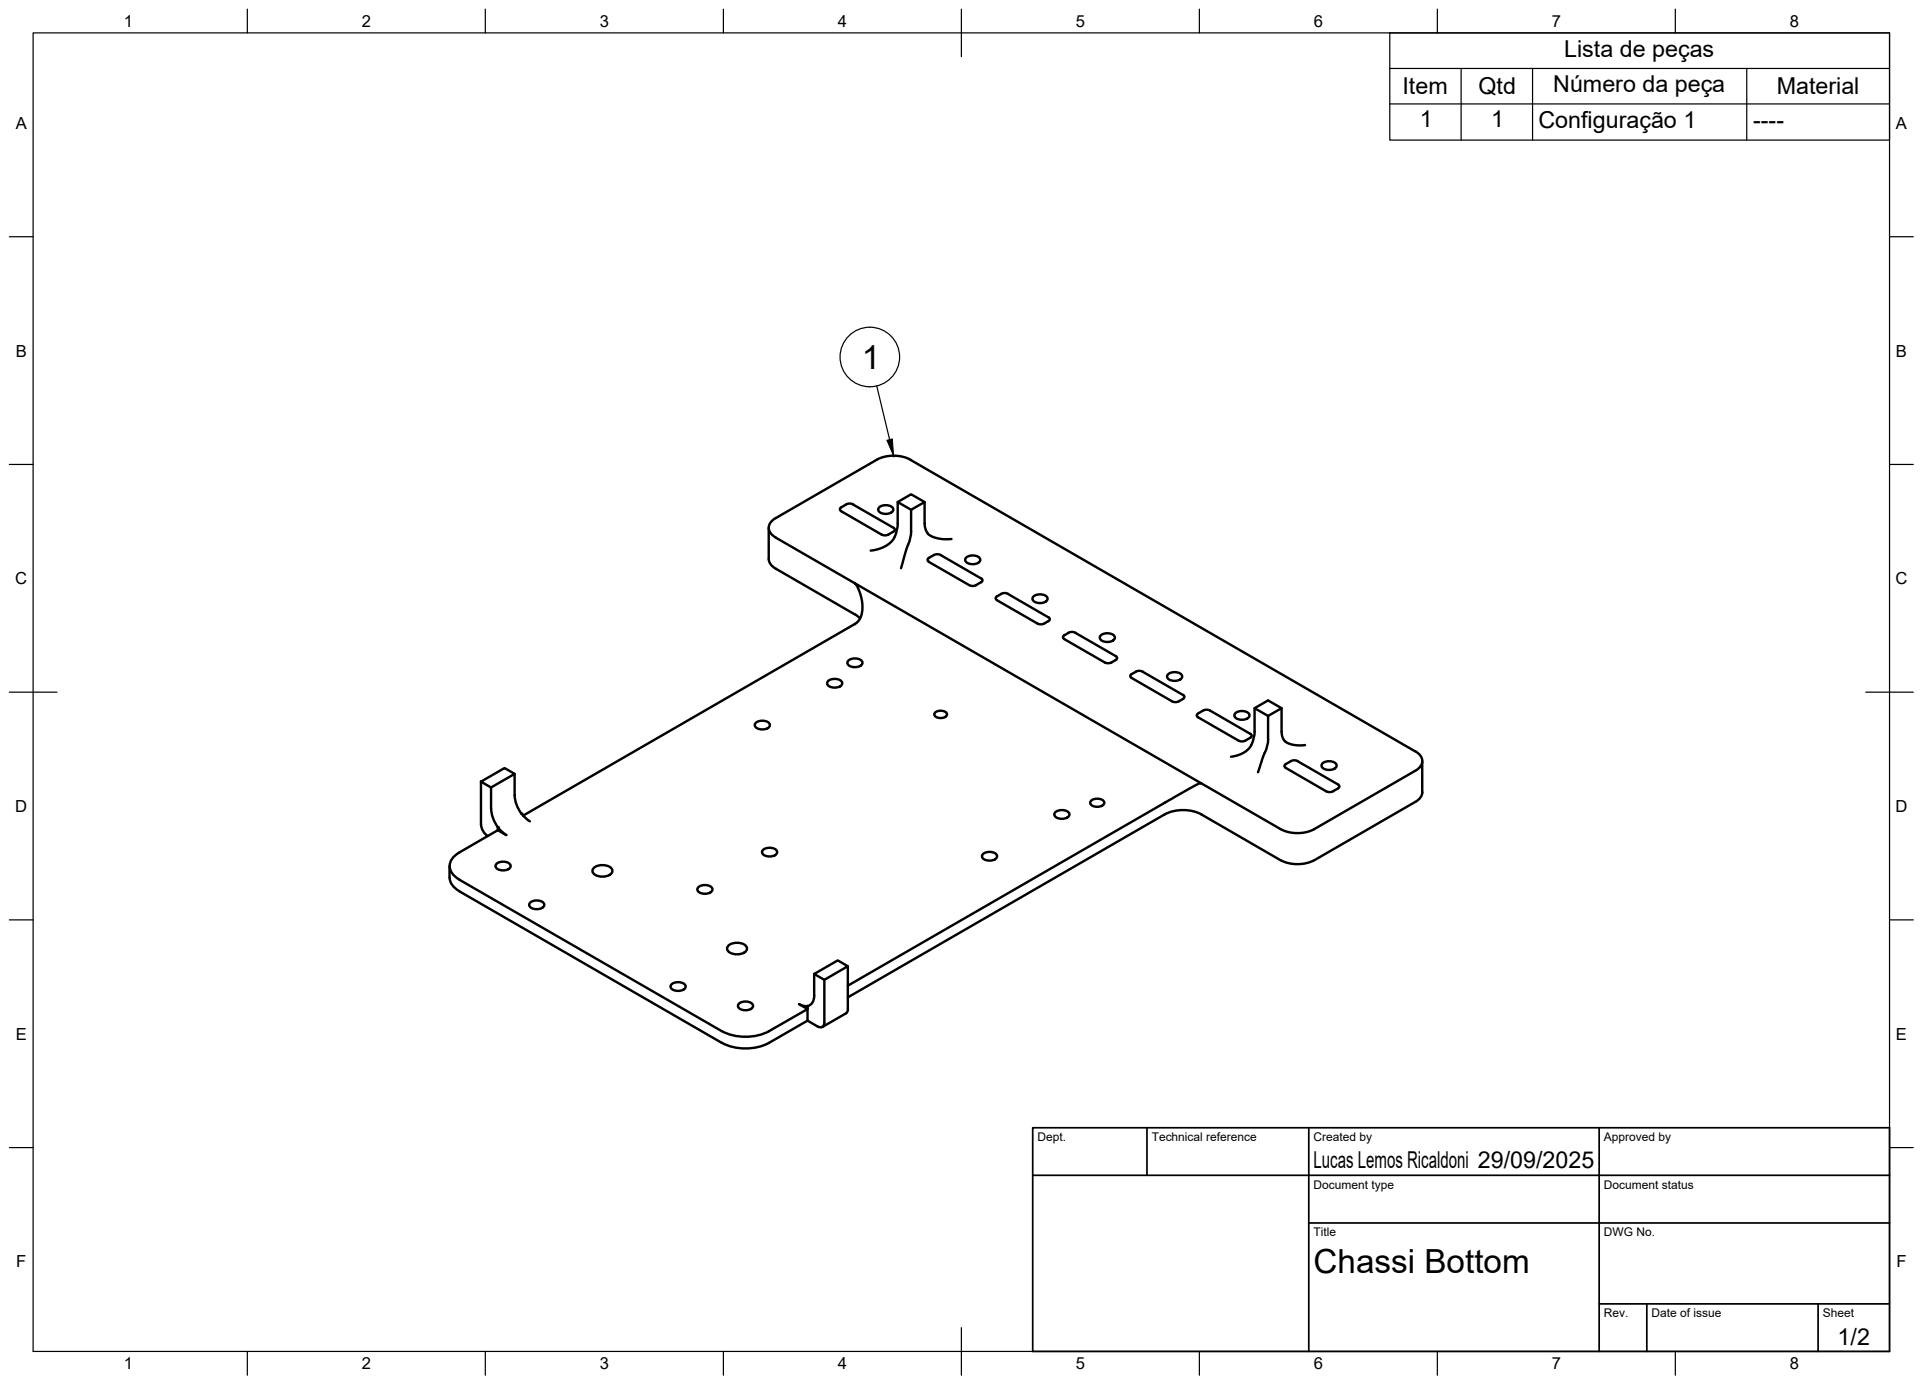
[picture p8: page 1]
Dept.; Technical reference; Created by; Approved by; Document type; Document status; Title; DWG No.; Rev.; Date of issue; Sheet; Chassi Bottom; Item; Qtd; Número da peça; Material; Configuração 1

Lista de peças

Lucas Lemos Ricaldoni

A

A

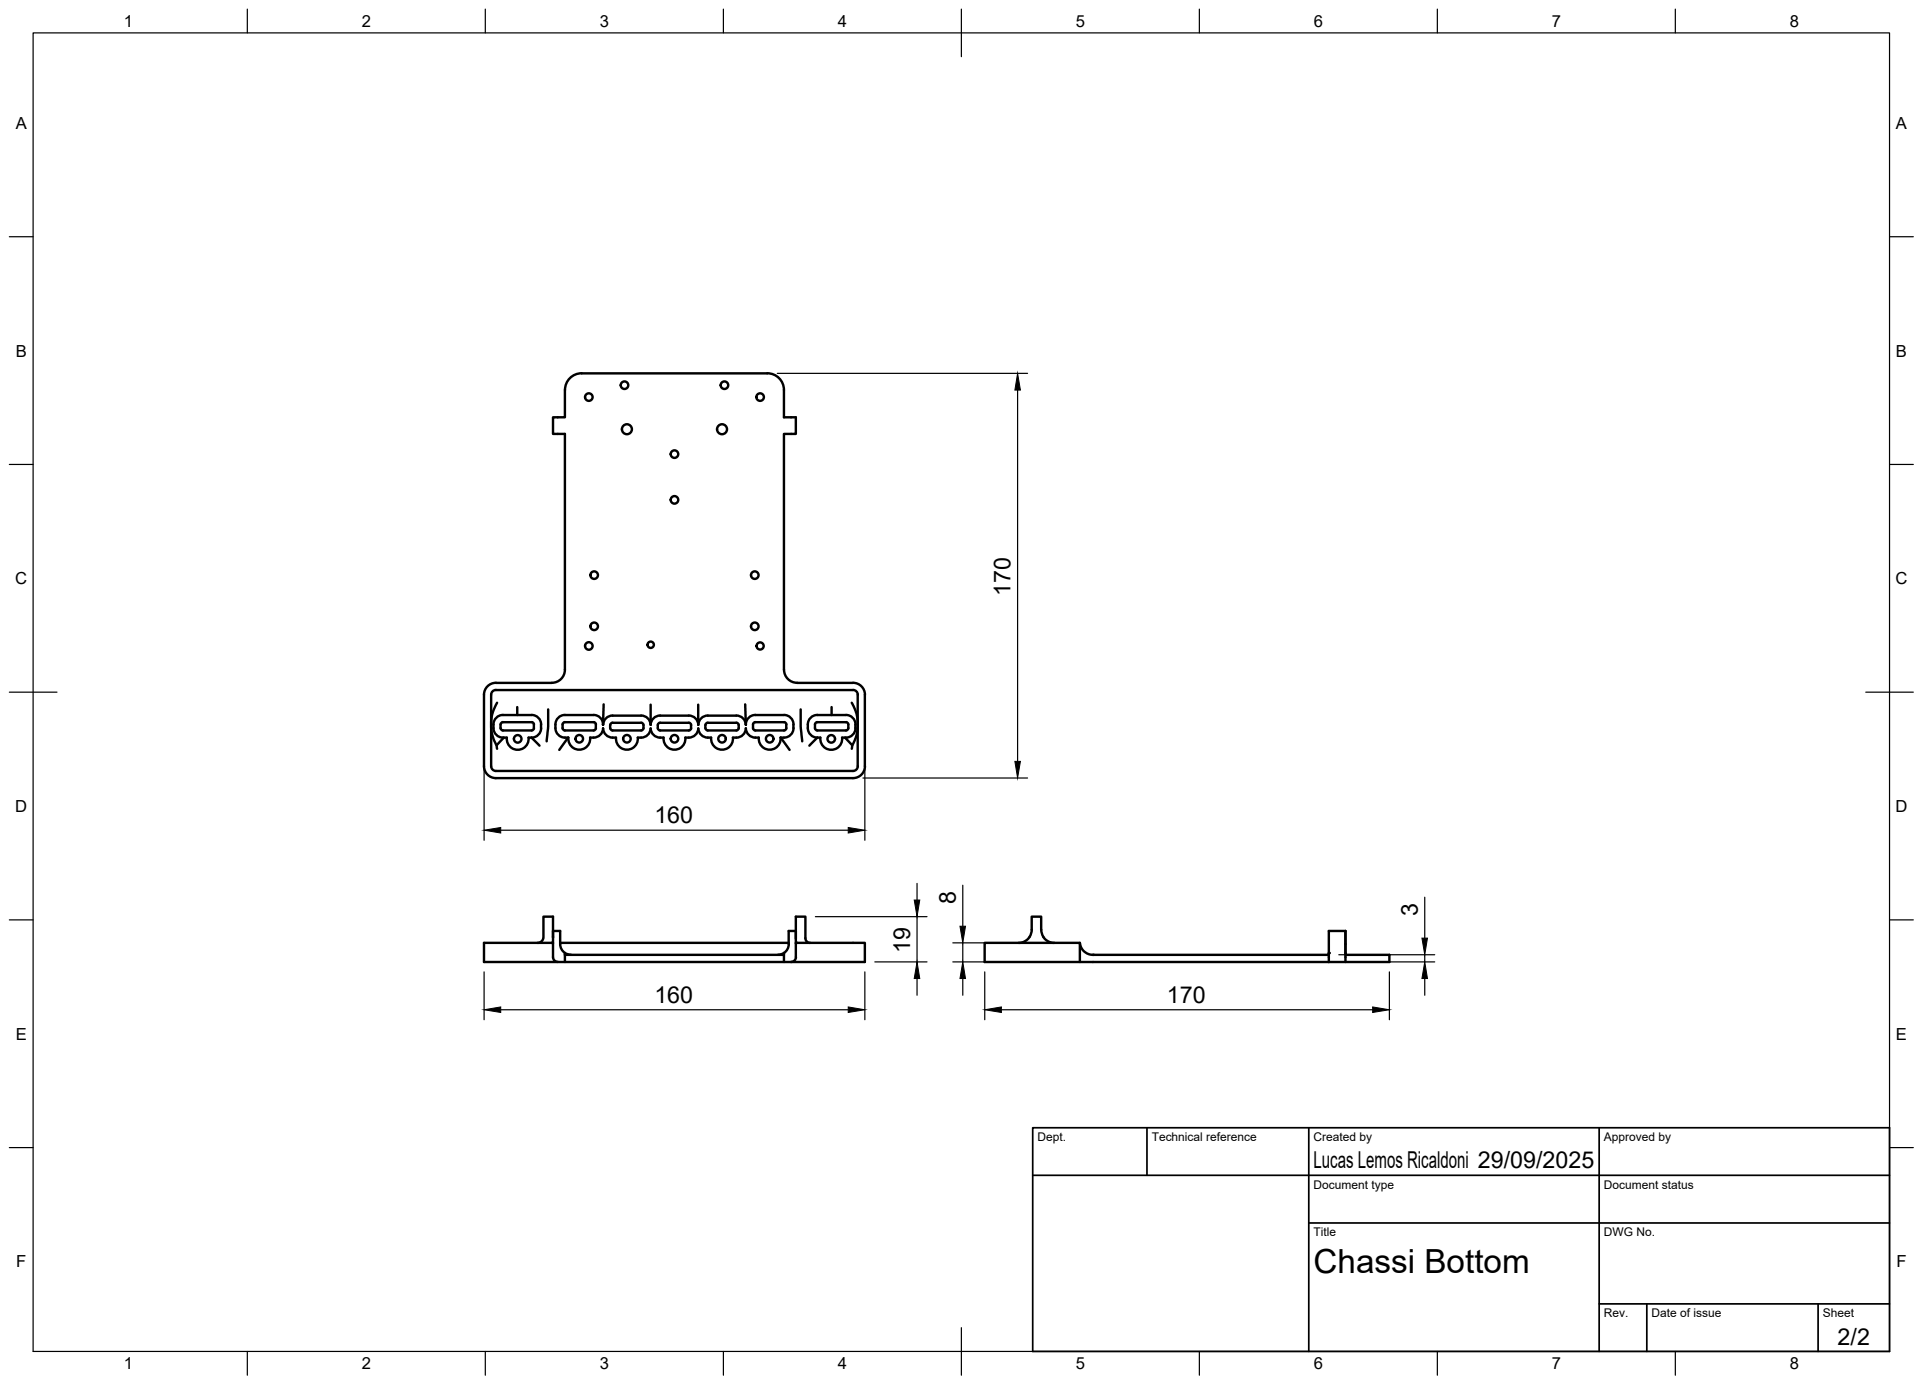
[picture p9: page 2]
Dept.; Technical reference; Created by; Approved by; Document type; Document status; Title; DWG No.; Chassi Bottom

Lucas Lemos Ricaldoni

A

A

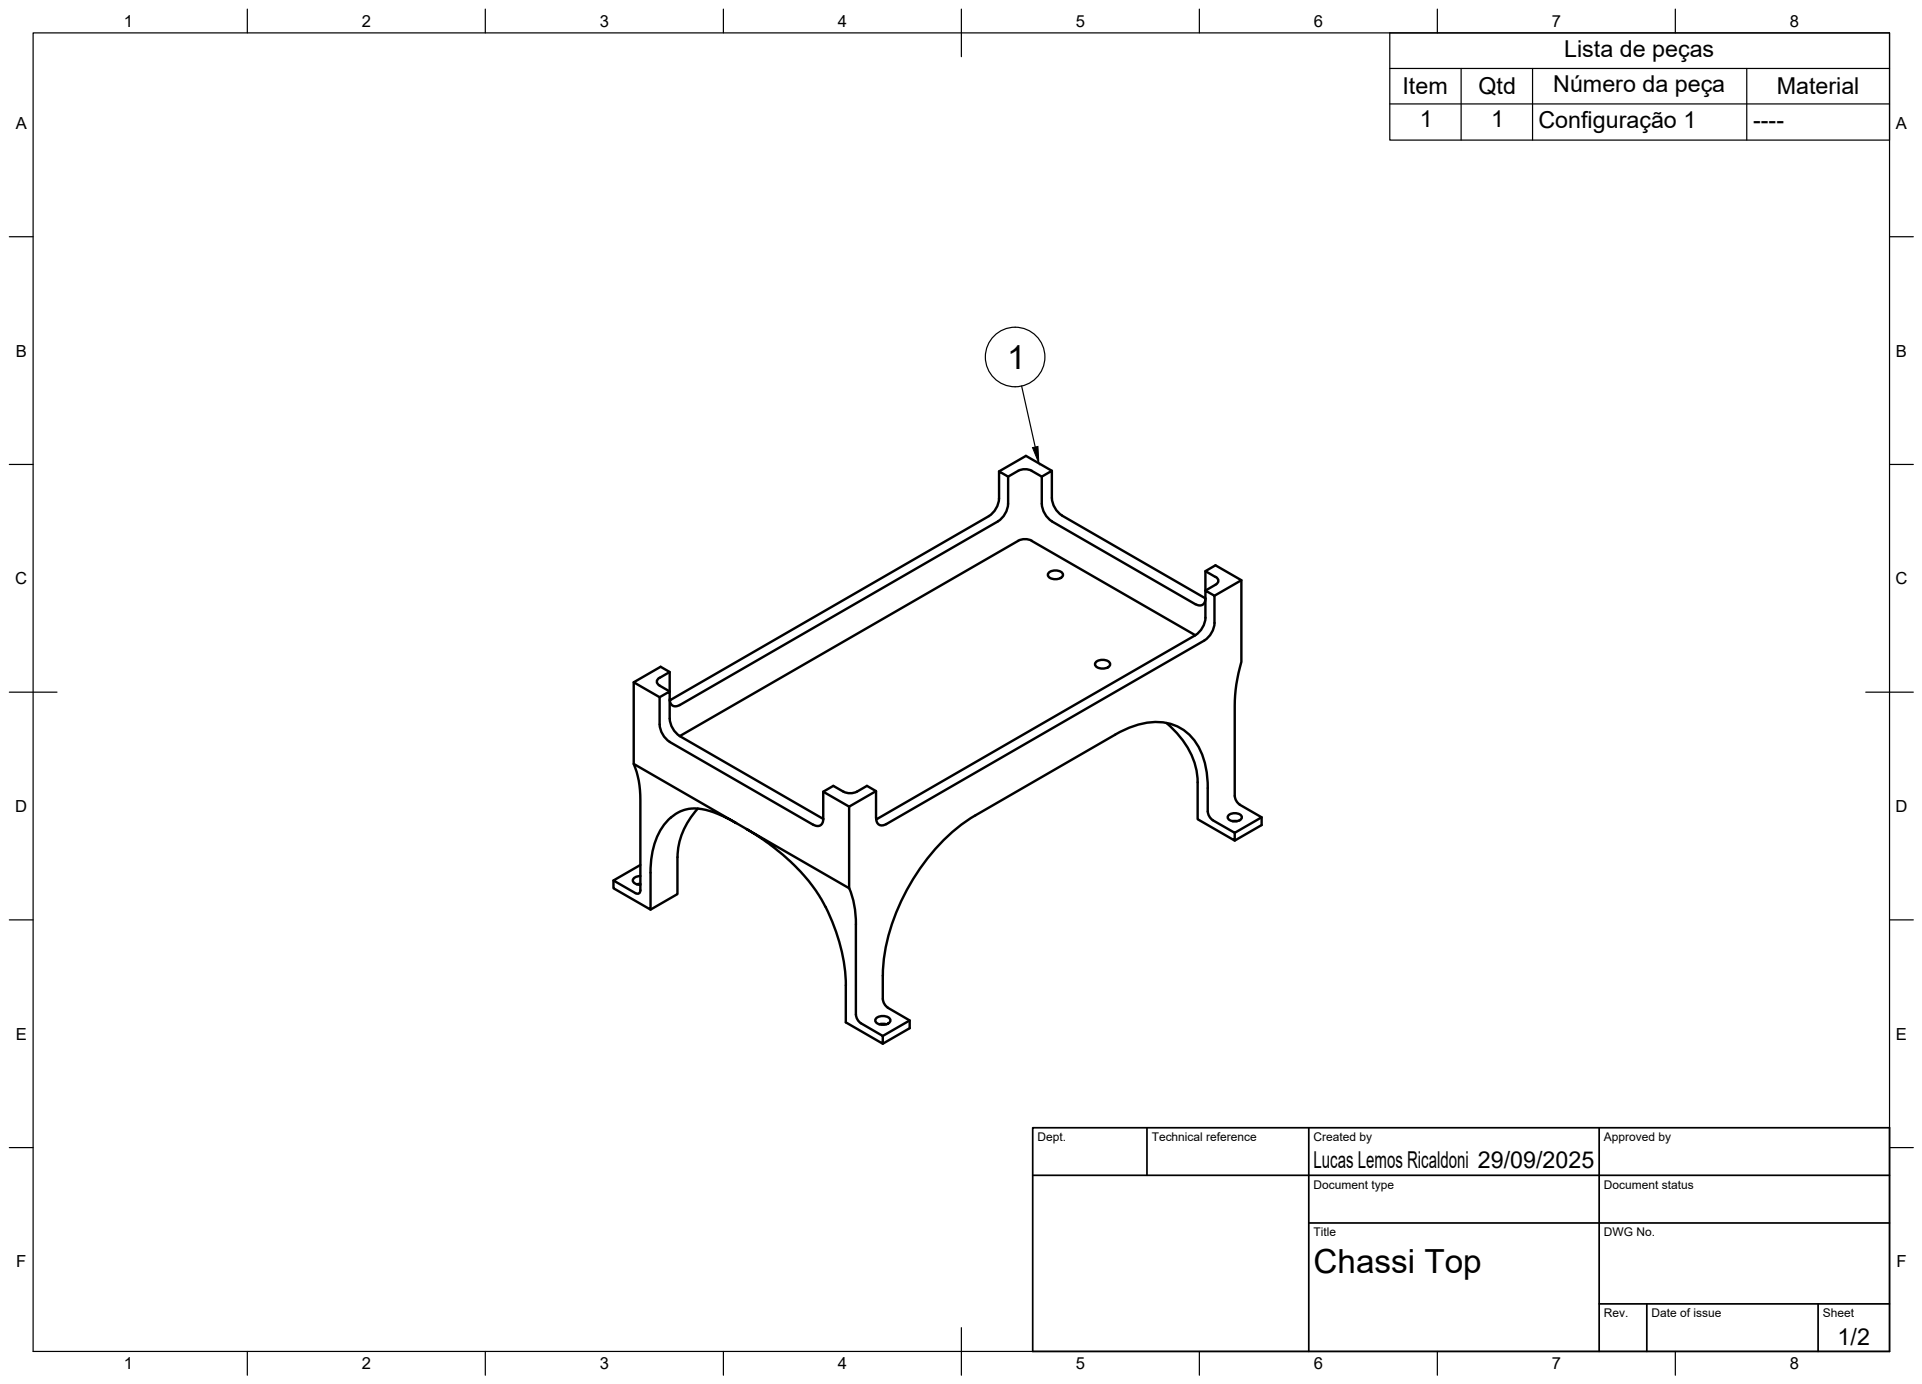
[picture p10: page 3]
Dept.; Technical reference; Created by; Approved by; Document type; Document status; Title; DWG No.; Chassi Top; Item; Qtd; Número da peça; Material; Configuração 1

Lista de peças

Lucas Lemos Ricaldoni

A

A

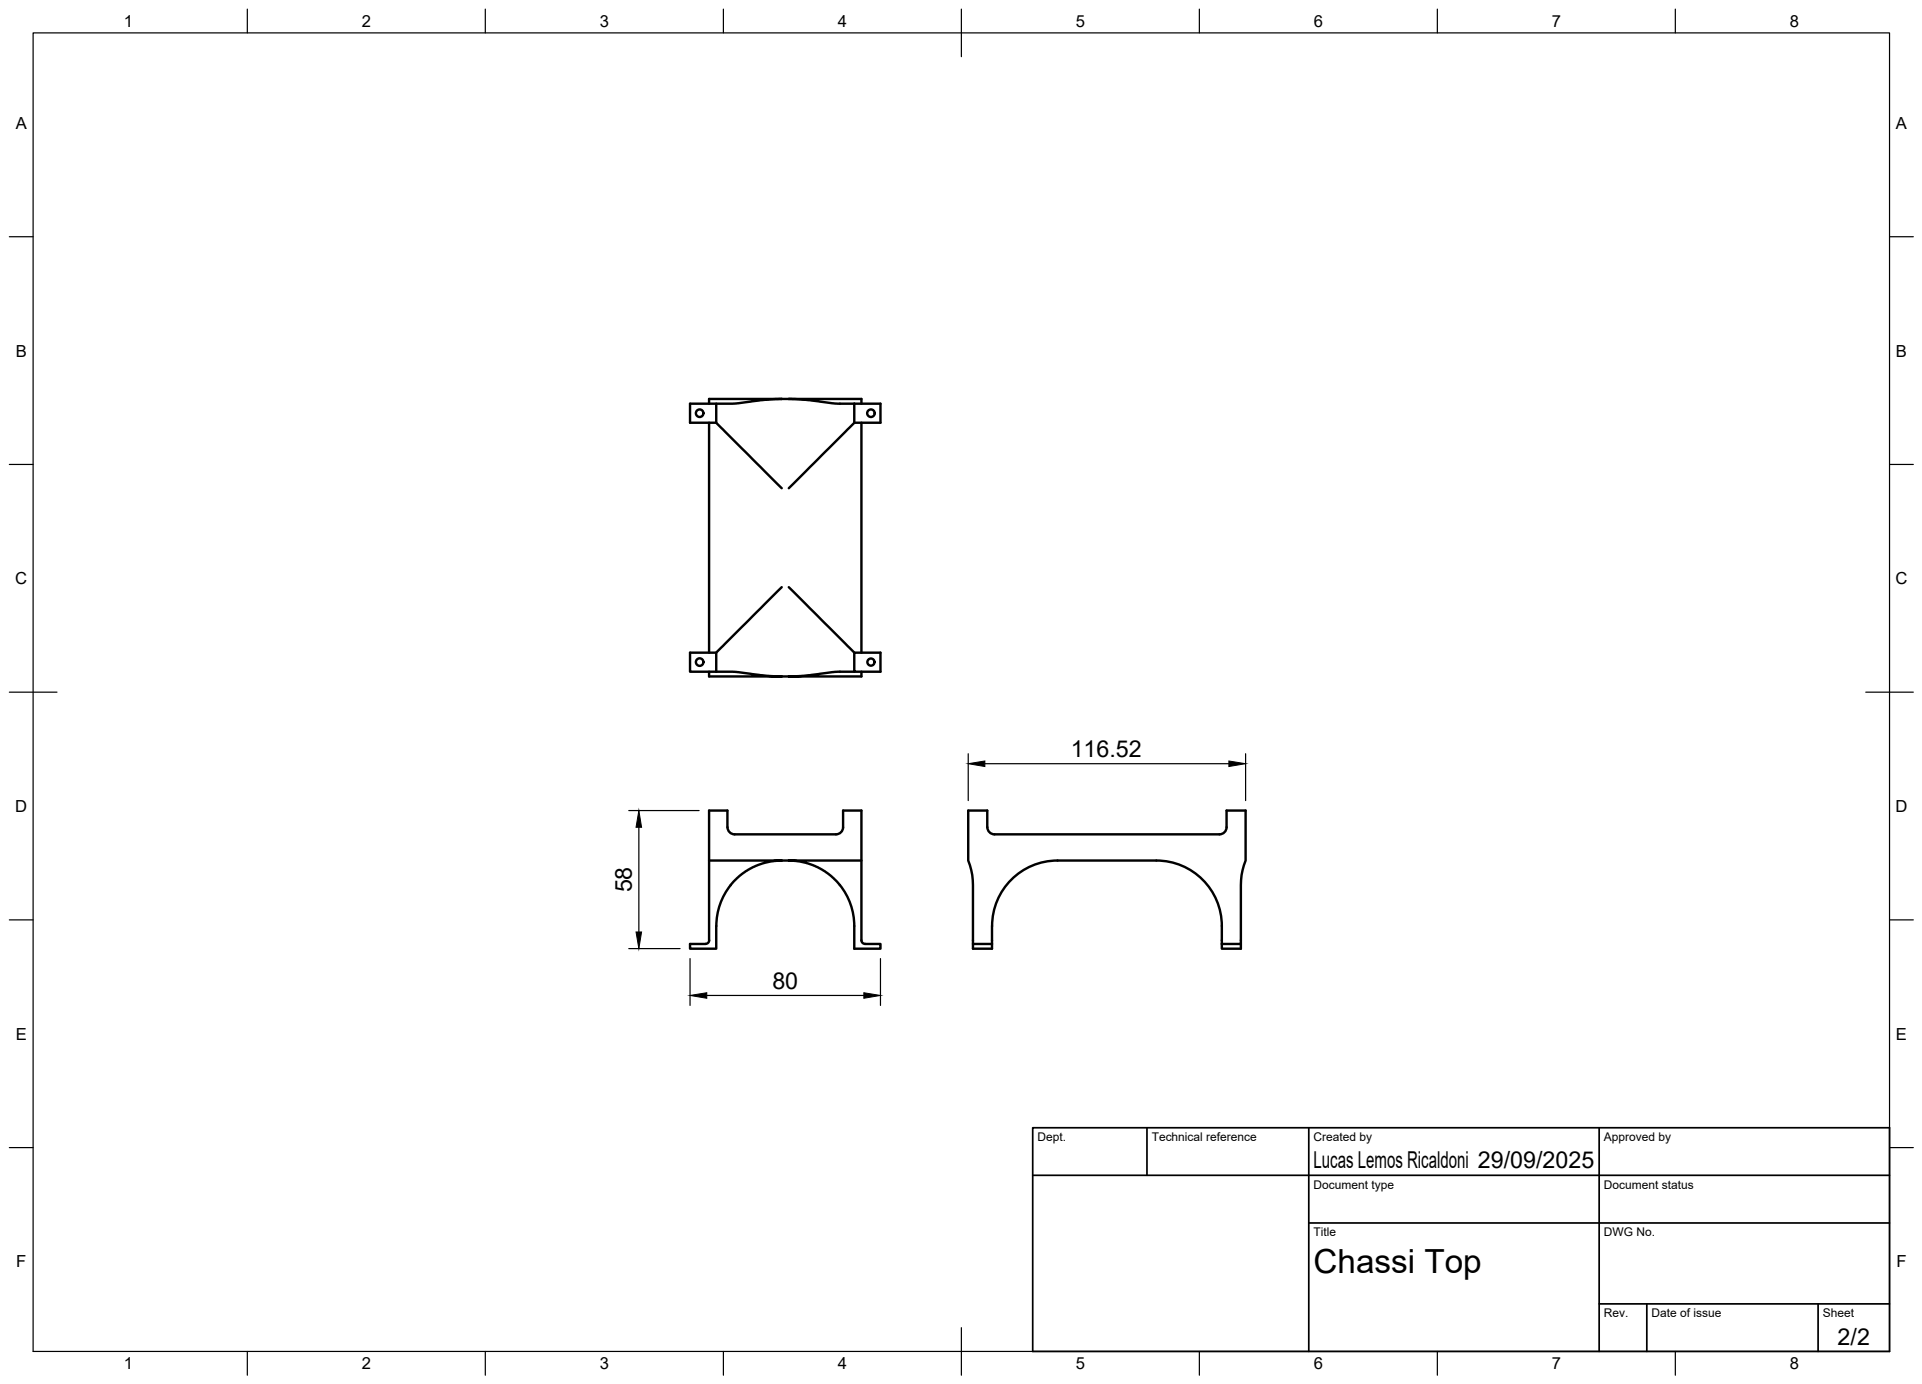
[picture p11: page 4]
Dept.; Technical reference; Created by; Approved by; Document type; Document status; Title; DWG No.; Chassi Top

Lucas Lemos Ricaldoni
