lemosslucas/CoRA2025/miscellaneous/chassi_top.pdf

Title; DWG No.; Rev.; Date of issue; Sheet; Chassi Top

Lista de peças

Item | Qtd | Número da peça | Material
1 | 1 | Configuração 1 | ----

Dept. | Technical reference | Created by Lucas Lemos Ricaldoni 29/09/2025 | Approved by

Document type | Document status

Title; DWG No.; Rev.; Date of issue; Sheet; Chassi Top

Dept. | Technical reference | Created by Lucas Lemos Ricaldoni 29/09/2025 | Approved by

Document type | Document status
