lemosslucas/CoRA2025/(commit log)

2025-07-30 area de parada e tentativa de voltar a linha adicionada
2025-07-30 teste de componentes
2025-07-30 resolvendo bug de importacao
    [CoRA2025.h, CoRA2025.ino, challenges.cpp, challenges.h, constants.cpp, constants.h]
2025-07-31 mudancas para o codigo compilar
2025-08-06 update pin values
2025-08-08 mudando nome dos sensores
2025-08-08 debug motor
2025-08-12 add serial print conditions
2025-08-26 deu varias voltas sem perder a linha, mas nn faz 90
2025-08-26 arrumando curva de 90 e faixa de pedestre
2025-08-27 curva de 90 instavel, começa a dar 360 no meio das curvas, invers]ao ta ruim, melhorar log
2025-08-28 ajuste no log e detecacao de inversaO
2025-08-29 passando reto da curva de 90, nn ta voktando direito, parando do nada eolhar o pid
2025-08-30 mudancas para melhor desempenho (tirei a rotatoria e a faixa de pedestre
2025-08-31 ta parando bonitinho mas ta pecando na curva de 90, curvando de 90 quando não deve
2025-09-01 possivel solucao pra deteccao de curva
2025-09-06 possivel curva de 90
2025-09-06 curva para direita vai para a direita
2025-09-07 verifica curva de 90
2025-09-07 ajuste na curva de 90 cm o pid
2025-09-07 resolvendo erros do controlador
    [CoRA2025.ino]
2025-09-08 carro fazendo 19 curvas de 90
2025-09-08 adicao de faixa de pedestre
2025-09-10 problema na faixa e curva
    [CoRA2025.ino, challenges.cpp]
2025-09-10 falta alinhar antes de atravessar a faixa
2025-09-11 quase feita a faixa de pedestre
2025-09-13 curva de 90 atualizada pra marcacao, falta pedestre, rotatoria e re
2025-09-15 deu certo a faixa de pedestre mas so se ela desalinharate o sensor de curva
